dplars/TWI/LaTeX/template/bu/README

This is a template for the students from the FIIW, KU Leuven Technology campus De Nayer. Feel free to edit it to your needs.

The required files are: 
  parallel.sty
  fiiw_denayer_eng.sty
  cover_fiiw_denayer_eng.pdf
  back_fiiw_denayer_eng.pdf
  thesis.tex
The other files are examples.

Remarks can be sent to:
Jannes Verstichel <jannes.verstichel@cs.kuleuven.be>
