dplars/TWI/zim/Verslagen/Inloopperiode_verslag.txt

Content-Type: text/x-zim-wiki
Wiki-Format: zim 0.6
Creation-Date: 2020-11-20T12:22:35+01:00

====== Inloopperiode verslag ======
Created vrijdag 20 november 2020

Het ingediende inloopperiode verslag is [[~/Documents/Lars.nosync/Documents/School/1Ma ing/Masterproef/officiele documenten/Verslagen/Inloopperiode verslag/Definitief/InloopPeriodeVerslag_TWI.pdf|hier]] terug te vinden
