dplars/TWI/LaTeX/TussenTijdsVerslag/FromZim/Verslagen/Activiteiten_rapport/Done.tex

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

\usepackage{listings}

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

\title{Done}
\date{dinsdag 08 december 2020}
\author{}

\begin{document}

\maketitle

		\section{Done}

Created vrijdag 20 november 2020

\subsection{Wat is er reeds gedaan deze periode tot 10 November?}

\subsection{Week 05/10/2020 - 11/10/2020}

opstellen en indienen van het tussentijds verslag in de eerste helft van de week.

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

\subsection{Week 12/10/2020 - 18/10/2020}

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

\subsection{Week 19/10/2020 - 25/10/2020}

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

\subsection{Week 26/10/2020 - 1/11/2020}

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

\subsection{Week 02/11/2020 - 08/11/2020}

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

\subsection{Week 09/11/2020 - 15/11/2020}

\begin{enumerate}[1]
\item Oplossen van het \href{../../Code/Problems/arduino_loop_time.tex}{probleem van de trage communicatie} tussen de computer en arduino. 
	\begin{enumerate}[a]
	\item Dit lag aan een time delay die gezet was voor het inlezen van een nieuwe lijn van de seriele input. 
		\begin{enumerate}[1]
		\item door de tijd te verlagen van de delay was het probleem al grotendeels verholpen. (van 1 seconde naar 10 miliseconden)
		\item Door een nieuw line end karakter te kiezen was het probleem volledig weg. Dit stond op '$\backslash$0', wijzigen naar / was voldoende om het einde van de lijn aan te geven
		\end{enumerate}
	\end{enumerate}
\item Nieuwe foto's nemen met de aangepaste code. Te zien in second dataset
\item Een \href{../../Camera_setup/Tool_Holder/Wheel_Holder/Second_Wheel_Holder.tex}{nieuw rad} ontwerpen dat toelaat om de plaatjes makkelijker te monteren en demonteren door clips te gebruiken waardoor de plaatjes niet met hun snijkant moeten glijden over plastiek. Dit zorgt er ook voor dat de clips makkelijk kunnen aangepast worden om met toekomstige veranderingen mee te kunnen.
	\begin{enumerate}[a]
	\item Het 3D model van de plaatjes online gevonden waardoor de juiste afmetingen bekend waren.
	\item Het 3D model printen zorgde er voor dat de afmetingen van de modellen niet werden gerespecteerd. Hierdoor pasten de eerste tests niet. Door Steeds 0.4 mm extra te rekenen voor elke maat paste het wel. 
	\item De clips werden geprint met een langere midelste pin om deze makkelijk van het rad te kunnen verwijderen. 
	\end{enumerate}
\item Bijwonen van de presentaties van twee studenten die in januari hun masterproef zullen indienen om een beeld te krijgen van hoe de presentaties in elkaar zitten.
\item Alle bestanden die tot hiertoe gemaakt zijn reorganiseren en opslaan in GITHUB.
	\begin{enumerate}[a]
	\item werken met meerdere branches. 
	\item Master branch 
	\item develop branch
	\item feature/\textless{}featurename\textgreater{} branch
	\end{enumerate}
\item Belichten van de fotos verliep zeer goed, alleen was het zeer moeilijk om de camera te positioneren en scherp te stellen met de huidige standaard. Hiervoor werd gevraagd of nieuwe materialen konden besteld worden om deze standaard te vervangen.
\item Vraag om ander print materiaal te kunnen gebruiken voor de print van de clips. Nu werd witte PLA gebruikt wat nogal snel afbreekt, met PETG hopen we de problemen niet meer te hebben.
\item Aanmaken van een \href{../../Vision/Dataset/handmade_datasets/Second_handmade_dataset.tex}{nieuwe dataset} met de eerste batch van plaatjes gezien niet duidelijk was welke kant de a kant was en welke de b-kant.
	\begin{enumerate}[a]
	\item Dit werd gedaan met een simpele setup waarbij de camera op de bureau stond en handmatig werden van alle plaatjes foto's genomen en vergeleken met de gekregen foto's van Sirris.
	\item Blijkt dat de B kant de kant is met de streep
	\end{enumerate}
\end{enumerate}

\subsection{Week 16/11/2020 - 22/11/2020}

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

\subsection{Week 23/11/2020 - 29/11/2020}

Dinsdag 24/11/2020

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

Woensdag 25/11/2020

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

\subsection{Week 30/11/2020 - 06/12/2020}

Maandag, dinsdag

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

Woensdag

Overige clips en rad geprint en plaatjes op de raden gestoken. 

Een deel gedocumenteerd over de aangelegde datasets:

\begin{itemize}
\item \href{../../Vision/Dataset/automated_datasets/1_check_camera_position/1_camera_position_side.tex}{Vision:Dataset:automated datasets:1 check camera position:1 camera position side} aangevuld
\item \href{../../Vision/Dataset/automated_datasets/1_check_camera_position/2_camera_position_top.tex}{Vision:Dataset:automated datasets:1 check camera position:2 camera position top} aangevuld
\item \href{../../Vision/Dataset.tex}{Vision:Dataset} aangevuld
\end{itemize}

Afwerken van de setup door toevoeging van nieuwe staander voor motor

aanmaken van een nieuwe dataset genaamd spaghetti met vier foto's per plaatje

foto's van spaghetti door algoritme laten gaan en sweep laten uitvoeren. Eerste resultaten zien er zeer slecht uit. Slechtere accuracy dan bij de vorige dataset die met de hand was gemaakt. (\href{../../Vision/Dataset/handmade_datasets/Second_handmade_dataset.tex}{second handmade dataset)}

Wel meer data om te testen en valideren. Test resultaten zien er wel beter uit.

wandb proberen instellen om te runnen vanaf mijn eigen computer tot hiertoe zonder succes

Vrijdag

Documenteren van de verschillende tests die uitgevoerd werden op de verkregen datasets.

zie:

\begin{itemize}
\item \href{../../Vision/GoogleColab/Test_Camera_Setup/All_Networks/All_Networks_1.tex}{All networks 1}
\item \href{../../Vision/GoogleColab/Test_Camera_Setup/All_Networks/All_Networks_2.tex}{All networks 2}
\item \href{../../Vision/GoogleColab/Test_Camera_Setup/All_Networks/All_Networks_4_Spaghetti.tex}{All networks 4 Spaghetti}
\item \href{../../Vision/GoogleColab/Test_Camera_Setup/All_Networks/All_networks_4_spaghetti_first_5_batches.tex}{All networks 4 Spaghetti first 5 batches}
\end{itemize}

Aanmaken pagina met foto's van \href{../../Camera_setup/Tool_Holder/Wheel_Holder/Second_Wheel_Holder.tex}{nieuw rad v2}

Datasets documenteren:

\href{../../Vision/Dataset/automated_datasets/2_created_datasets/2_Spaghetti_dataset.tex}{Spaghetti dataset}

\end{document}
