dplars/TWI/LaTeX/TussenTijdsVerslag/FromZim/Vision/Dataset/camera_position.tex

\documentclass{scrartcl}
\usepackage[mathletters]{ucs}
\usepackage[utf8x]{inputenc}
\usepackage{amssymb}
\usepackage{amsmath}
\usepackage[usenames]{color}
\usepackage{hyperref}
\usepackage{wasysym}
\usepackage{graphicx}
\usepackage[normalem]{ulem}
\usepackage{enumerate}

\usepackage{listings}

\lstset{ %
basicstyle=\footnotesize,       % the size of the fonts that are used for the code
showspaces=false,               % show spaces adding particular underscores
showstringspaces=false,         % underline spaces within strings
showtabs=false,                 % show tabs within strings adding particular underscores
frame=single,                   % adds a frame around the code
tabsize=2,                      % sets default tabsize to 2 spaces
breaklines=true,                % sets automatic line breaking
breakatwhitespace=false,        % sets if automatic breaks should only happen at whitespace
}

\title{camera position}
\date{dinsdag 08 december 2020}
\author{}

\begin{document}

\maketitle

		\section{camera position}

Created woensdag 11 november 2020

1st test was with a camera position more to the side of the cutting plates. This resulted in a bad reflection angle since the light came from the wrong side. Documentation of this set is in \href{./automated_datasets/1_check_camera_position/1_camera_position_side.tex}{automated datasets:1 check camera position:1 camera position side} 

\end{document}
