dplars/TWI/LaTeX/TussenTijdsVerslag/FromZim/Vision/Dataset/handmade_datasets/second_initial_dataset.tex

\documentclass{scrartcl}
\usepackage[mathletters]{ucs}
\usepackage[utf8x]{inputenc}
\usepackage{amssymb}
\usepackage{amsmath}
\usepackage[usenames]{color}
\usepackage{hyperref}
\usepackage{wasysym}
\usepackage{graphicx}
\usepackage[normalem]{ulem}
\usepackage{enumerate}

\usepackage{listings}

\lstset{ %
basicstyle=\footnotesize,       % the size of the fonts that are used for the code
showspaces=false,               % show spaces adding particular underscores
showstringspaces=false,         % underline spaces within strings
showtabs=false,                 % show tabs within strings adding particular underscores
frame=single,                   % adds a frame around the code
tabsize=2,                      % sets default tabsize to 2 spaces
breaklines=true,                % sets automatic line breaking
breakatwhitespace=false,        % sets if automatic breaks should only happen at whitespace
}

\title{second initial dataset}
\date{dinsdag 08 december 2020}
\author{}

\begin{document}

\maketitle

		\section{second initial dataset}

Created vrijdag 04 december 2020

With the second number of inserts (batch 11 to 19) another dataset was created for measurement.

Since the photo's where labeled with two inserts at a time; the images taken where not relevant for the data processing and were not saved

The distance for these inserts is measured between the line connecting the two highest points visible on the insert and the outer most point of the wear area.

\end{document}
