dplars/TWI/zim/Code/Arduino/Control_motor_leds.txt

Content-Type: text/x-zim-wiki
Wiki-Format: zim 0.6
Creation-Date: 2020-12-02T17:33:06+01:00

====== Control motor leds ======
Created woensdag 02 december 2020

current working file is control_motor_leds
