dplars/TWI/LaTeX/template/private_oudestijl/back_fiiw_bruges_eng.pdf

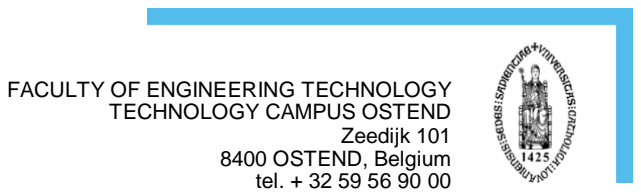
[picture p57: figure]
FACULTY OF ENGINEERING TECHNOLOGY TECHNOLOGY CAMPUS OSTEND Zeedijk 101 8400 OSTEND, Belgium

tel. + 32 59 56 90 00
fet.ostend@kuleuven.be
www.fet.kuleuven.be
