dplars/TWI/LaTeX/template/private_oudestijl/back_fiiw_denayer_eng.pdf

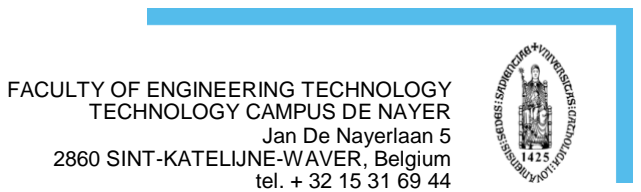
[picture p58: figure]
FACULTY OF ENGINEERING TECHNOLOGY TECHNOLOGY CAMPUS DE NAYER Jan De Nayerlaan 5 2860 SINT-KATELIJNE-WAVER, Belgium

tel. + 32 15 31 69 44
fet.denayer@kuleuven.be
www.fet.kuleuven.be
