dplars/TWI/LaTeX/template/private_oudestijl/back_fiiw_geel_eng.pdf

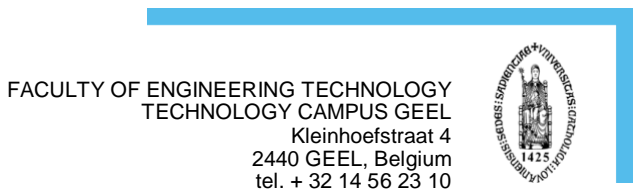
[picture p59: figure]
FACULTY OF ENGINEERING TECHNOLOGY TECHNOLOGY CAMPUS GEEL Kleinhoefstraat 4 2440 GEEL, Belgium

tel. + 32 14 56 23 10
fax + 32 14 58 48 59
fet.geel@kuleuven.be
www.fet.kuleuven.be
