dplars/TWI/LaTeX/template/bijlage1.tex

\chapter{Uitleg over de appendices}
Bijlagen worden bij voorkeur enkel elektronisch ter beschikking gesteld. Indien essentieel kunnen in overleg met de promotor bijlagen in de scriptie opgenomen worden of als apart boekdeel voorzien worden.

Er wordt wel steeds een lijst met vermelding van alle bijlagen opgenomen in de scriptie. Bijlagen worden genummerd het een drukletter A, B, C,...

Voorbeelden van bijlagen:\\
Bijlage A: \qquad	Detailtekeningen van de proefopstelling \\
Bijlage B: \qquad	Meetgegevens (op USB)
\\
