dplars/TWI/LaTeX/template/samenvatting.tex

De (korte) samenvatting, toegankelijk voor een breed publiek, wordt in het Nederlands geschreven en bevat {\bf maximum 3500 tekens}. Deze samenvatting moet ook verplicht opgeladen worden in KU Loket.
