dplars/TWI/LaTeX/template/voorwoord.tex

Het voorwoord vul je persoonlijk in met een appreciatie of dankbetuiging aan de mensen die je hebben bijgestaan tijdens het verwezenlijken van je masterproef en je hebben gesteund tijdens je studie.
