dplars/TWI/LaTeX/template/bu/samenvatting.tex

De (korte) samenvatting, toegankelijk voor een breed publiek, wordt in het Nederlands geschreven en bevat maximum 3500 tekens. Deze samenvatting moet ook verplicht opgeladen worden in KU Loket.
