dplars/TWI/LaTeX/template/private_oudestijl/back_fiiw_brugge.pdf

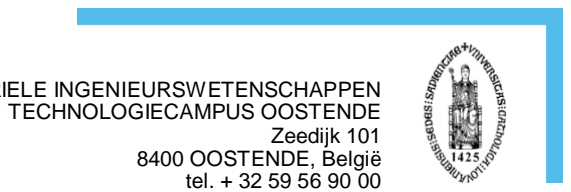
[picture p61: figure]
TECHNOLOGIECAMPUS OOSTENDE Zeedijk 101 8400 OOSTENDE, België

FACULTEIT INDUSTRIELE INGENIEURSWETENSCHAPPEN

tel. + 32 59 56 90 00
iiw.oostende@kuleuven.be
www.iiw.kuleuven.be
