dplars/TWI/LaTeX/template/private_oudestijl/back_fiiw_denayer.pdf

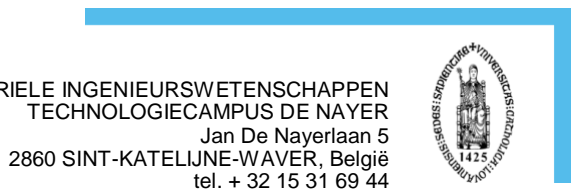
[picture p62: figure]
TECHNOLOGIECAMPUS DE NAYER Jan De Nayerlaan 5 2860 SINT-KATELIJNE-WAVER, België

FACULTEIT INDUSTRIELE INGENIEURSWETENSCHAPPEN

tel. + 32 15 31 69 44
iiw.denayer@kuleuven.be
www.iiw.kuleuven.be
