dplars/TWI/LaTeX/template/private_oudestijl/back_fiiw_geel.pdf

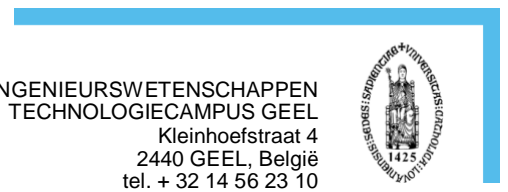
[picture p63: figure]
TECHNOLOGIECAMPUS GEEL Kleinhoefstraat 4 2440 GEEL, België

FACULTEIT INDUSTRIELE INGENIEURSWETENSCHAPPEN

tel. + 32 14 56 23 10
fax + 32 14 58 48 59
iiw.geel@kuleuven.be
www.iiw.kuleuven.be
