dplars/TWI/LaTeX/template/private_oudestijl/back_fiiw_groepT.pdf

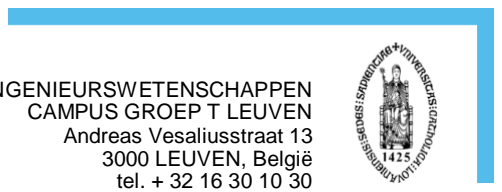
[picture p64: figure]
CAMPUS GROEP T LEUVEN Andreas Vesaliusstraat 13 3000 LEUVEN, België

FACULTEIT INDUSTRIELE INGENIEURSWETENSCHAPPEN

tel. + 32 16 30 10 30
fax + 32 16 30 10 40
iiw.groept @kuleuven.be
www.iiw.kuleuven.be
