dplars/TWI/LaTeX/TussenTijdsVerslag/TexMaker/fig/Verslagen/Activiteiten_rapport/Activities/Masterproef_Tool_Wear_Inspection_-_Update_2_DH/20201021_1725_004_0.000.jpg

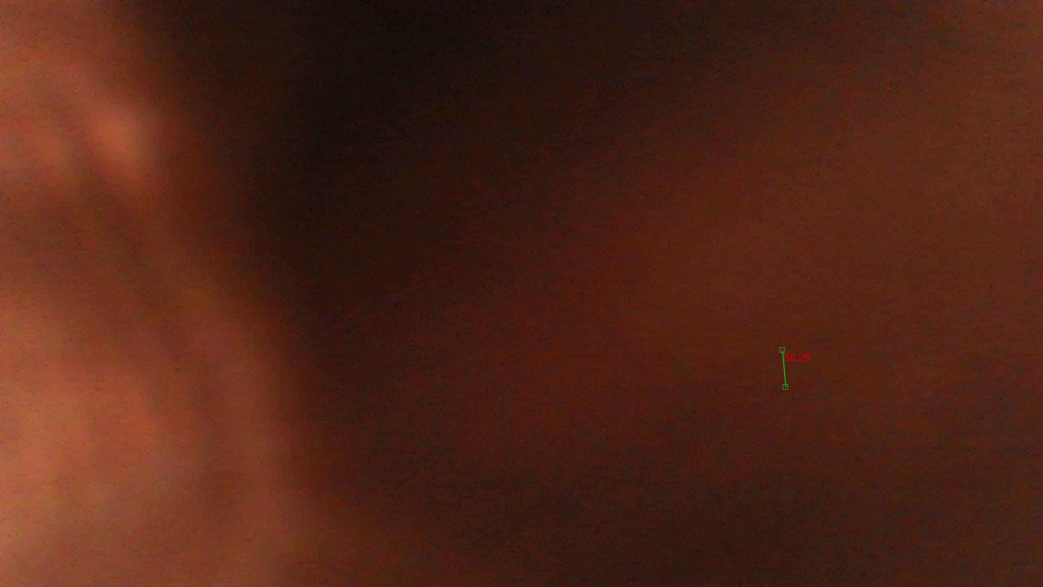
LaTeX/TussenTijdsVerslag/TexMaker/fig/Verslagen/Activiteiten_rapport/Activities/Masterproef_Tool_Wear_Inspection_-_Update_2_DH/20201021_1725_004_0.000.jpg
