dplars/TWI/LaTeX/TussenTijdsVerslag/TexMaker/fig/Verslagen/Activiteiten_rapport/Activities/Masterproef_Tool_Wear_Inspection_-_Update_2_DH/pasted_image.tiff

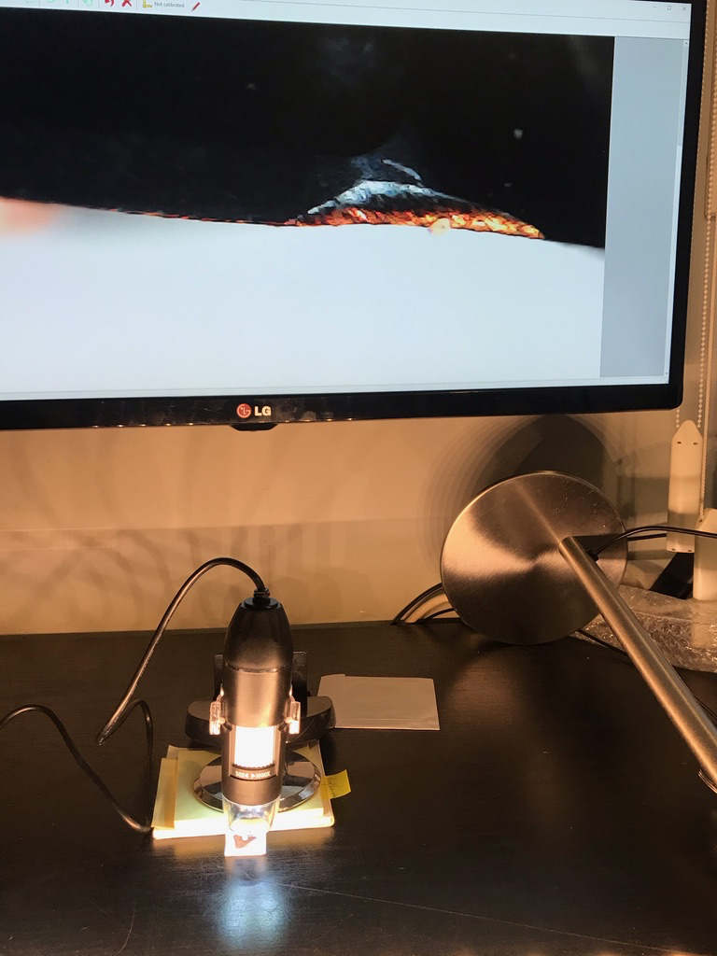
LaTeX/TussenTijdsVerslag/TexMaker/fig/Verslagen/Activiteiten_rapport/Activities/Masterproef_Tool_Wear_Inspection_-_Update_2_DH/pasted_image.tiff
