dplars/TWI/3Dprint/2020_profile/2020-aluminum-profile-1.snapshot.2/PROFILE_20х20.STEP

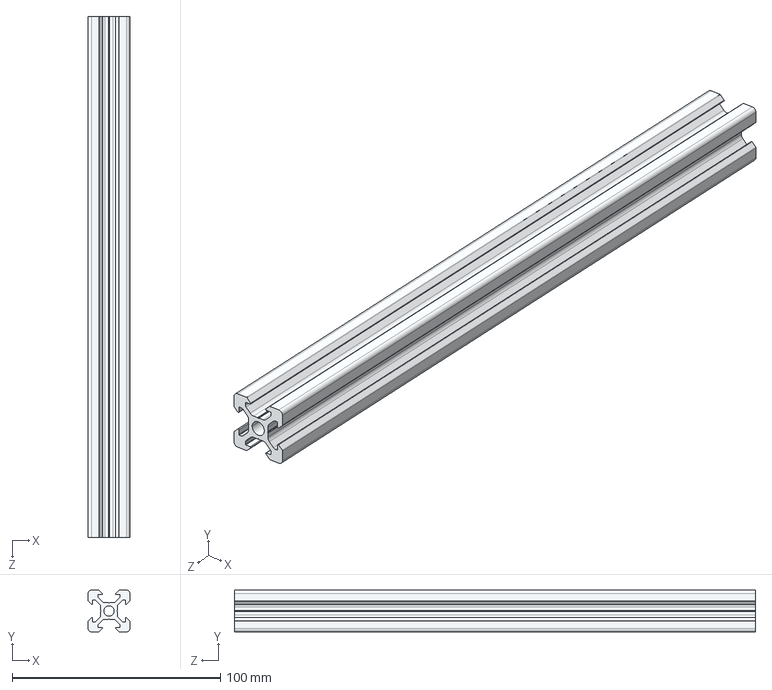
[picture p67: CAD file, 2020-12-16]
3Dprint/2020_profile/2020-aluminum-profile-1.snapshot.2/PROFILE_20х20.STEP
20.0 x 20.0 x 250.0 mm
