dplars/TWI/3Dprint/camera/USB Microscope_Generic/USB_Microscope_R0.SLDPRT

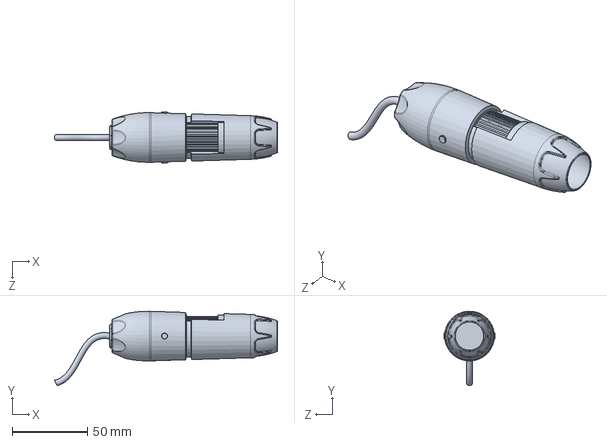
[picture p68: CAD file, 2020-12-12]
3Dprint/camera/USB Microscope_Generic/USB_Microscope_R0.SLDPRT
148.1 x 49.5 x 34.0 mm
