dplars/TWI/3Dprint/microscoophouder/20x20-shaped-aluminum-coupling-1.snapshot.1/20x20(tri2).stp

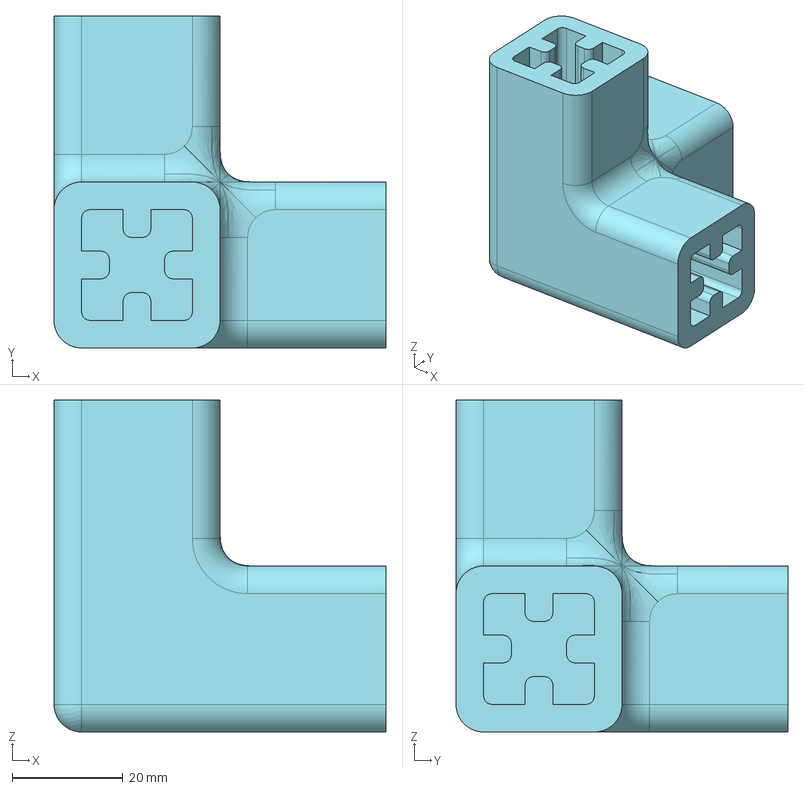
[picture p69: CAD file, 2020-12-02]
3Dprint/microscoophouder/20x20-shaped-aluminum-coupling-1.snapshot.1/20x20(tri2).stp
60.0 x 60.0 x 60.0 mm
