dplars/TWI/3Dprint/microscoophouder/camera_klem_1.stl

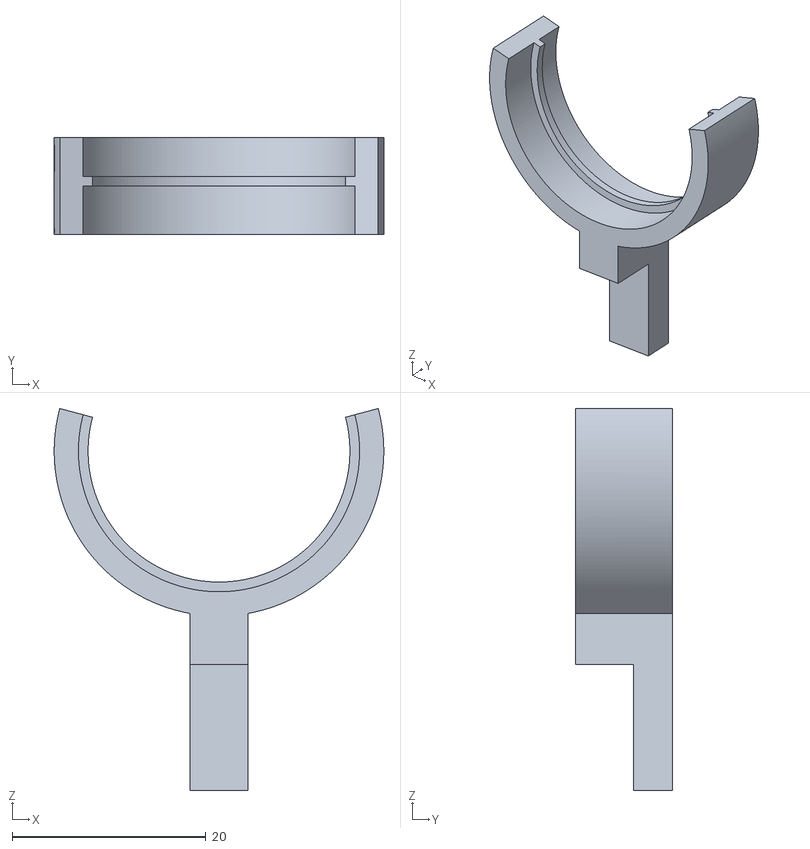
[picture p70: CAD file, 2020-12-02]
3Dprint/microscoophouder/camera_klem_1.stl
34.0 x 10.00 x 39.4
