dplars/TWI/3Dprint/radhouder_v2/clip_9.stl

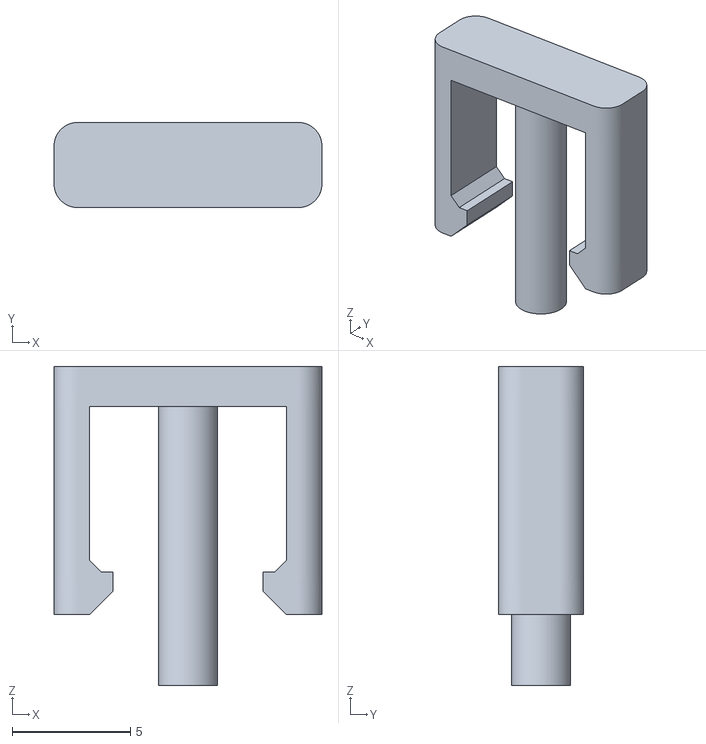
[picture p71: CAD file, 2020-12-04]
3Dprint/radhouder_v2/clip_9.stl
11.3 x 3.60 x 13.5
