dplars/TWI/3Dprint/setup/nema-17-22.snapshot.3/Holder nema17.SLDPRT

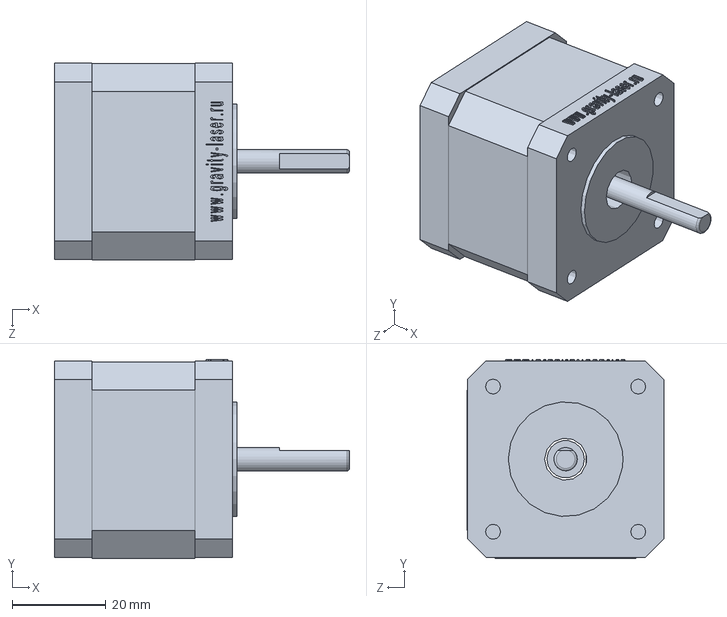
[picture p72: CAD file, 2020-12-16]
3Dprint/setup/nema-17-22.snapshot.3/Holder nema17.SLDPRT
63.0 x 42.5 x 42.1 mm
