dplars/TWI/3Dprint/Simpelehouder/klikhouder.stl

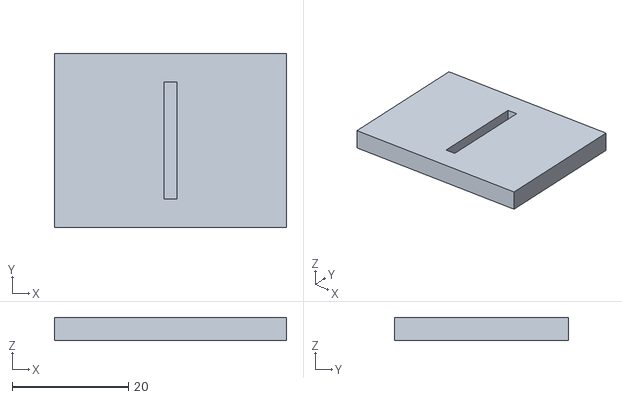
[picture p73: CAD file, 2020-11-13]
3Dprint/Simpelehouder/klikhouder.stl
40.0 x 30.0 x 4.00
