dplars/TWI/LaTeX/TussenTijdsVerslag/FromZim/Camera_setup/Tool_Holder/Wheel_Holder/radhouder.stl

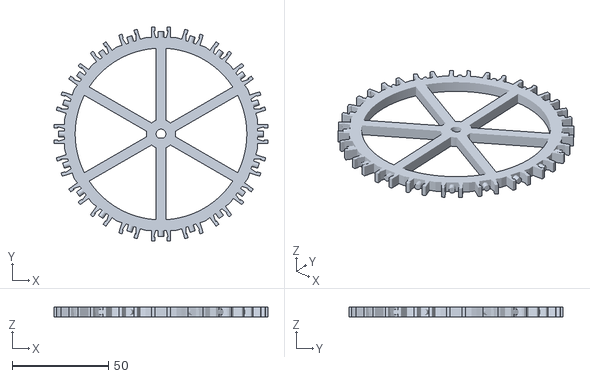
[picture p74: CAD file, 2020-11-13]
LaTeX/TussenTijdsVerslag/FromZim/Camera_setup/Tool_Holder/Wheel_Holder/radhouder.stl
111.0 x 111.0 x 5.00
