dplars/TWI/3Dprint/camera/USB Microscope_Generic/USB Microscope_Generic.STEP

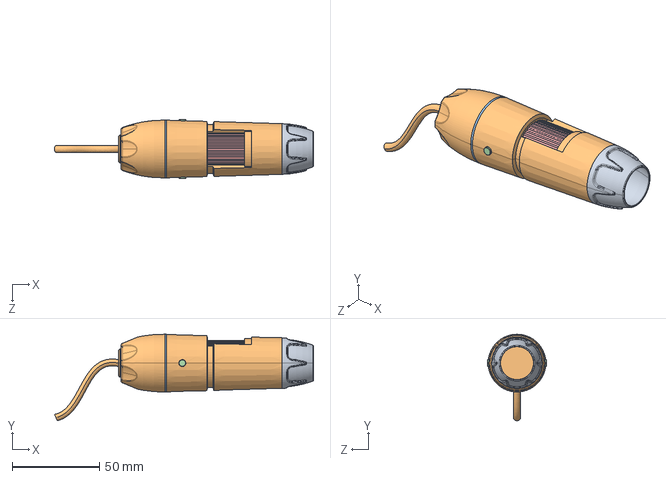
[picture p75: CAD file, 2020-12-12]
3Dprint/camera/USB Microscope_Generic/USB Microscope_Generic.STEP
148.1 x 49.5 x 34.0 mm
