dplars/TWI/3Dprint/microscoophouder/20x20-shaped-aluminum-coupling-1.snapshot.1/20x20(tri1).stp

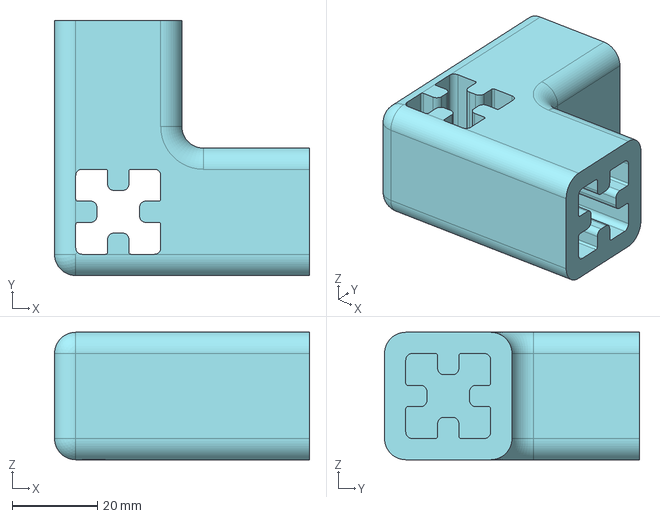
[picture p76: CAD file, 2020-12-02]
3Dprint/microscoophouder/20x20-shaped-aluminum-coupling-1.snapshot.1/20x20(tri1).stp
60.0 x 60.0 x 30.0 mm
