dplars/TWI/3Dprint/microscoophouder/Fuehrung_2020.stl

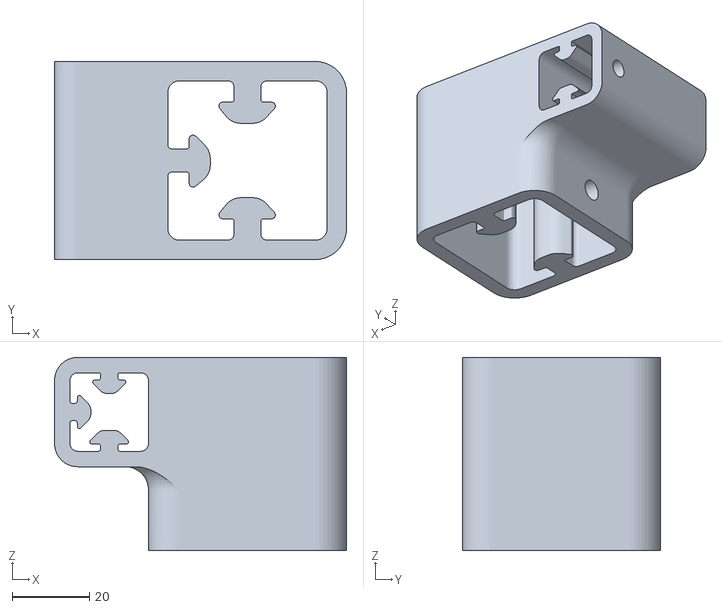
[picture p77: CAD file, 2020-12-02]
3Dprint/microscoophouder/Fuehrung_2020.stl
75.5 x 51.2 x 50.0
