dplars/TWI/3Dprint/radhouder_v2/clip_8.stl

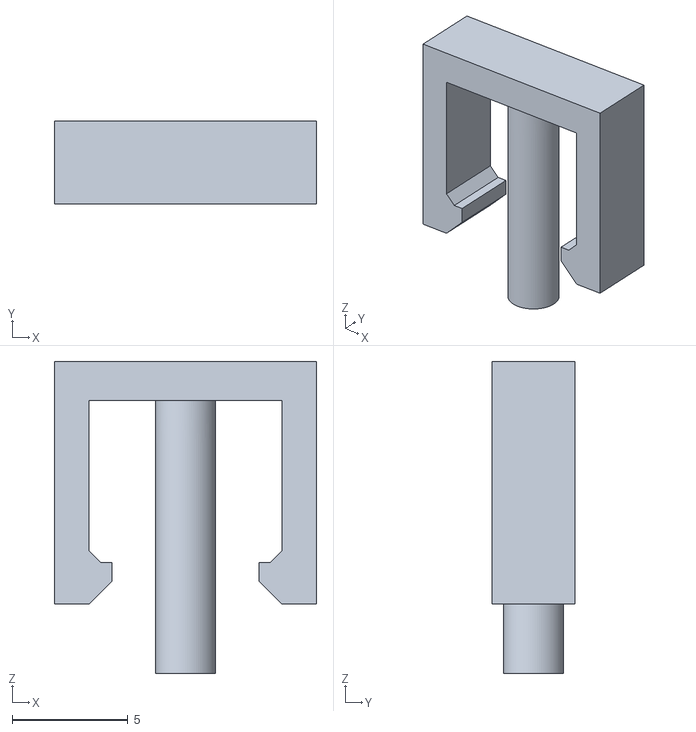
[picture p78: CAD file, 2020-12-02]
3Dprint/radhouder_v2/clip_8.stl
11.3 x 3.60 x 13.5
