dplars/TWI/3Dprint/Simpelehouder/simpeleHouderVertikaal.stl

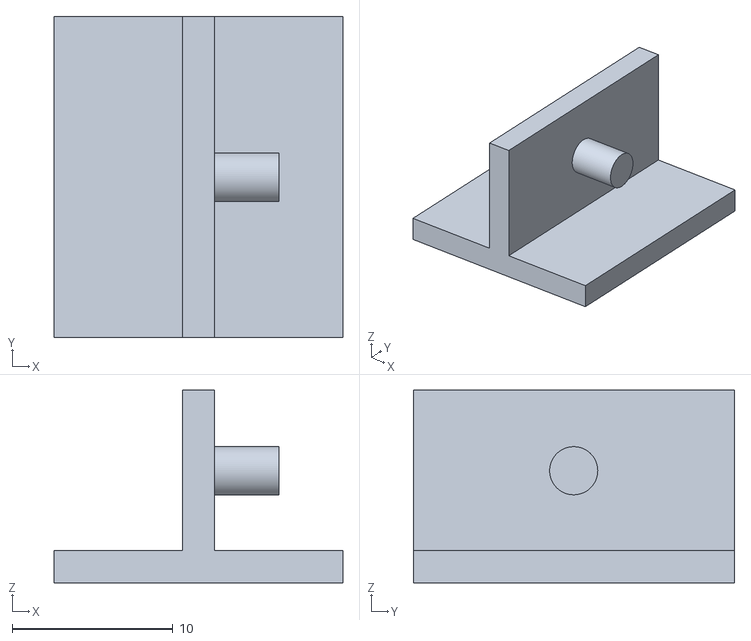
[picture p79: CAD file, 2020-11-13]
3Dprint/Simpelehouder/simpeleHouderVertikaal.stl
18.0 x 20.0 x 12.0
