dplars/TWI/3Dprint/microscoophouder/20x20-shaped-aluminum-coupling-1.snapshot.1/20x20(but).stp

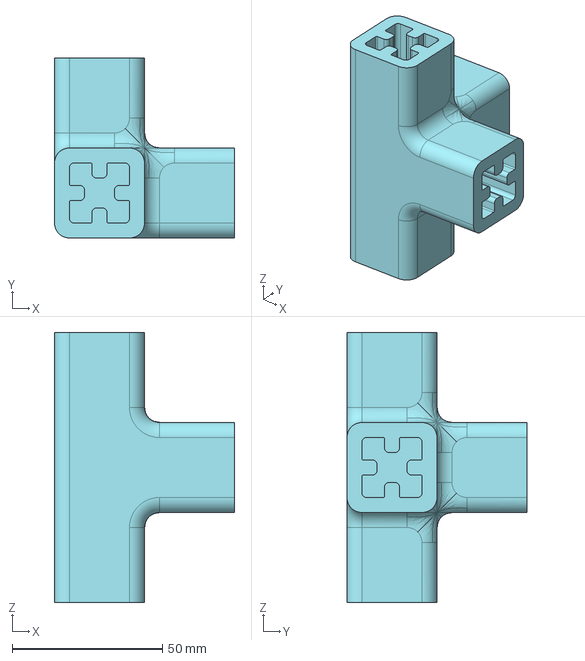
[picture p80: CAD file, 2020-12-02]
3Dprint/microscoophouder/20x20-shaped-aluminum-coupling-1.snapshot.1/20x20(but).stp
60.0 x 60.0 x 90.0 mm
