dplars/TWI/3Dprint/microscoophouder/mount.stl

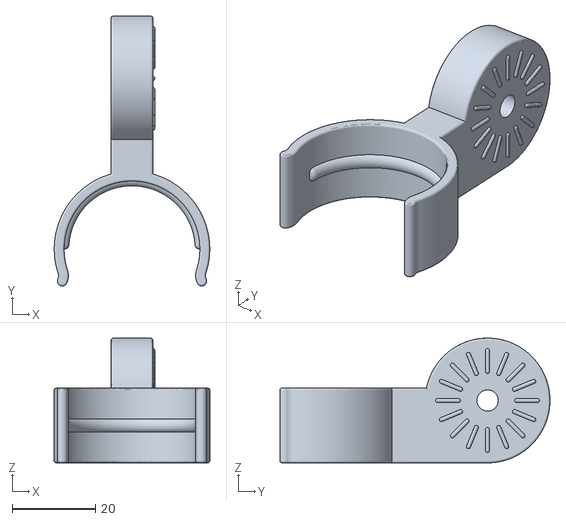
[picture p81: CAD file, 2020-12-02]
3Dprint/microscoophouder/mount.stl
37.4 x 64.9 x 30.0
