dplars/TWI/3Dprint/radhouder_v2/clip_p_5.stl

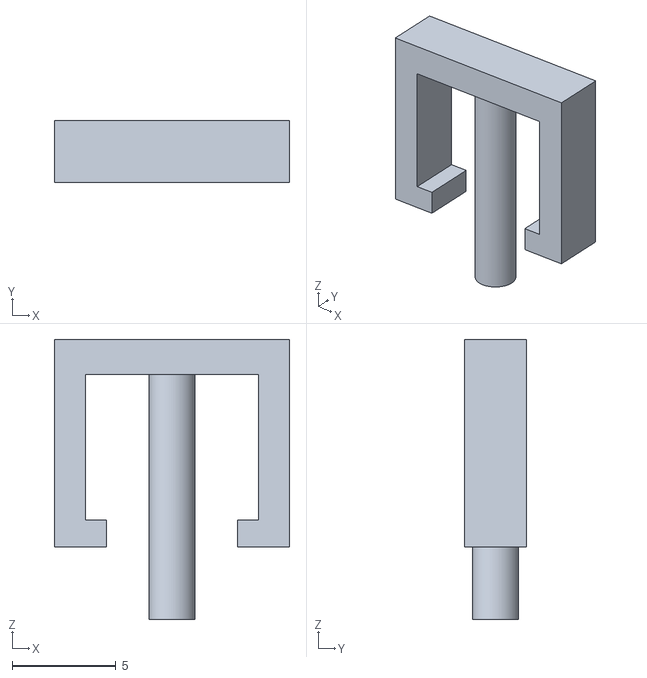
[picture p82: CAD file, 2020-12-02]
3Dprint/radhouder_v2/clip_p_5.stl
11.3 x 3.00 x 13.5
