dplars/TWI/3Dprint/Simpelehouder/simpeleHouder2.stl

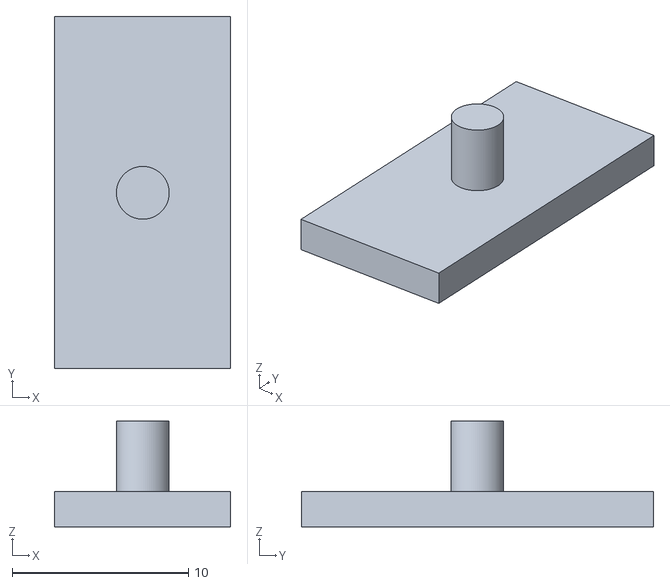
[picture p83: CAD file, 2020-11-13]
3Dprint/Simpelehouder/simpeleHouder2.stl
10.0 x 20.0 x 6.00
