dplars/TWI/3Dprint/microscoophouder/20x20-shaped-aluminum-coupling-1.snapshot.1/20x20(Double).stp

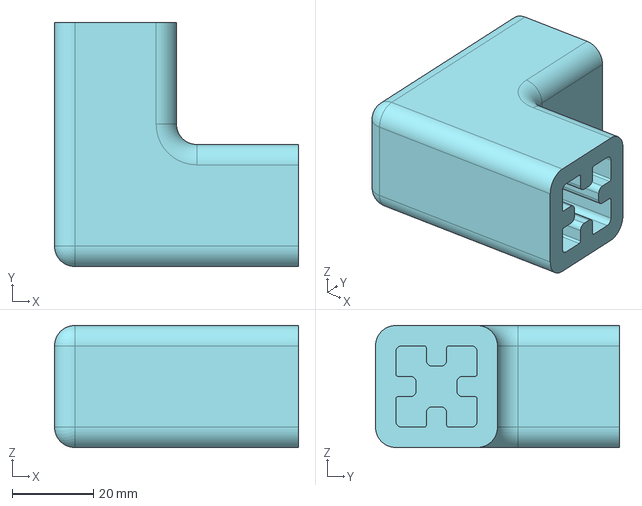
[picture p84: CAD file, 2020-12-02]
3Dprint/microscoophouder/20x20-shaped-aluminum-coupling-1.snapshot.1/20x20(Double).stp
60.0 x 60.0 x 30.0 mm
