dplars/TWI/3Dprint/microscoophouder/camera_houder_draai_houder_3.stl

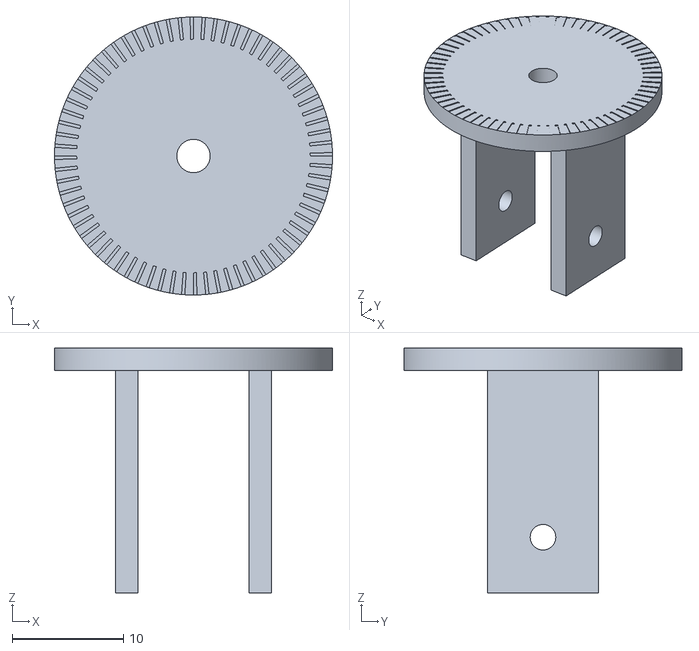
[picture p85: CAD file, 2020-12-02]
3Dprint/microscoophouder/camera_houder_draai_houder_3.stl
25.0 x 25.0 x 22.0
