dplars/TWI/3Dprint/radhouder_v2/clip_7.stl

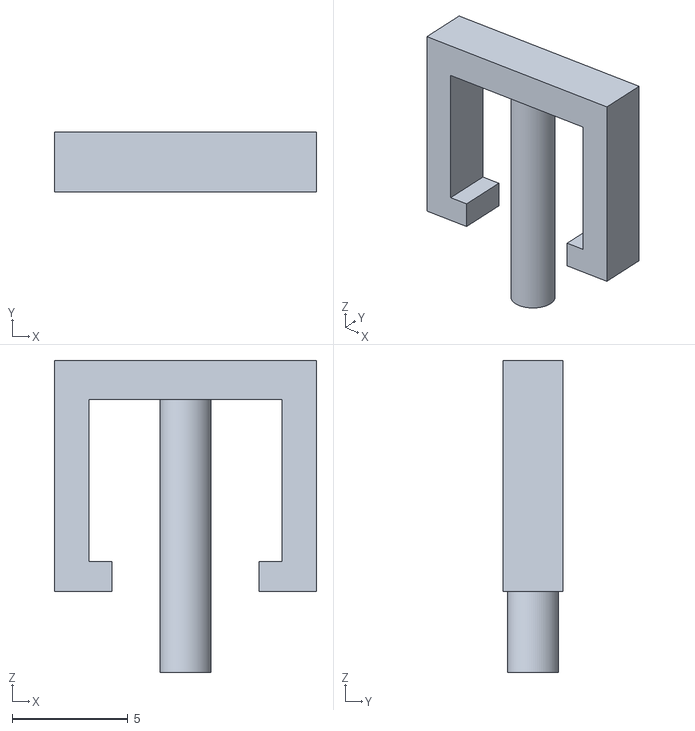
[picture p86: CAD file, 2020-12-02]
3Dprint/radhouder_v2/clip_7.stl
11.3 x 2.60 x 13.5
