dplars/TWI/3Dprint/Simpelehouder/simpelehouder_30grad.stl

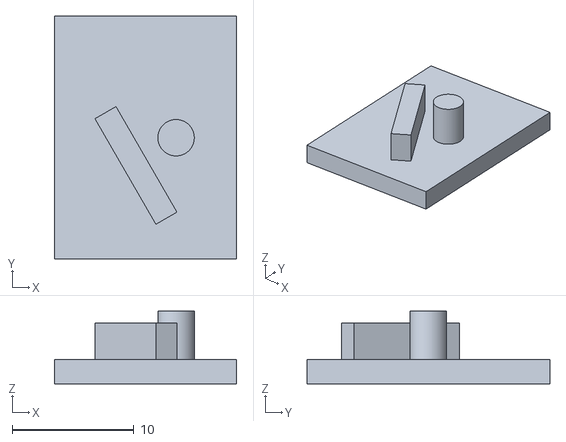
[picture p87: CAD file, 2020-11-13]
3Dprint/Simpelehouder/simpelehouder_30grad.stl
15.0 x 20.0 x 6.00
