dplars/TWI/3Dprint/microscoophouder/camera_houder_klem_3.stl

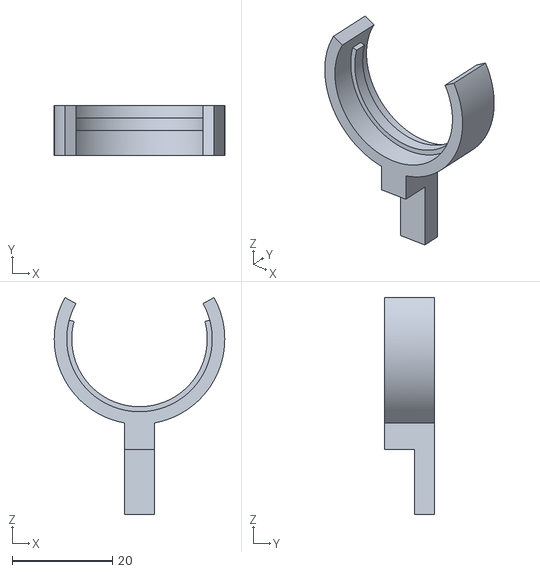
[picture p88: CAD file, 2020-12-02]
3Dprint/microscoophouder/camera_houder_klem_3.stl
34.0 x 10.00 x 43.3
