dplars/TWI/3Dprint/Simpelehouder/simpeleHouder_bredevoet.stl

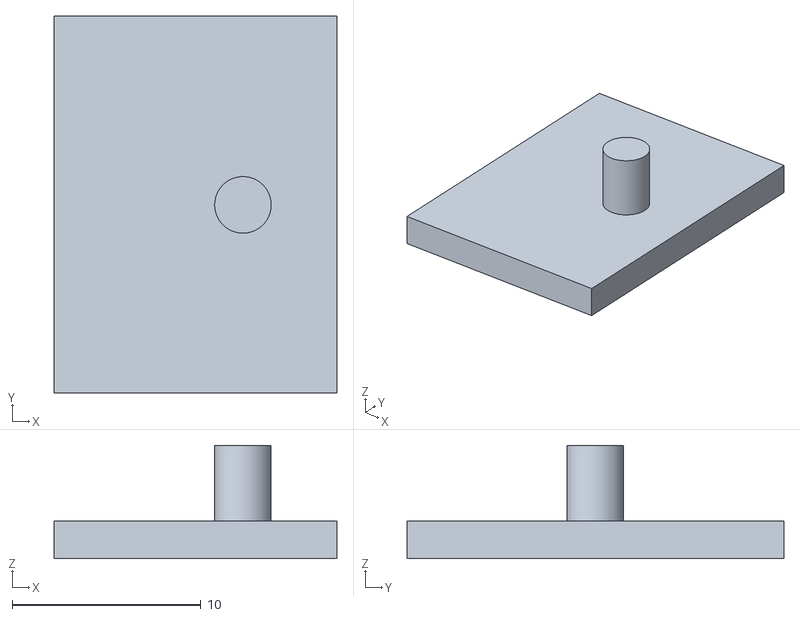
[picture p89: CAD file, 2020-11-13]
3Dprint/Simpelehouder/simpeleHouder_bredevoet.stl
15.0 x 20.0 x 6.00
