dplars/TWI/3Dprint/microscoophouder/2020_camera houder v1.stl

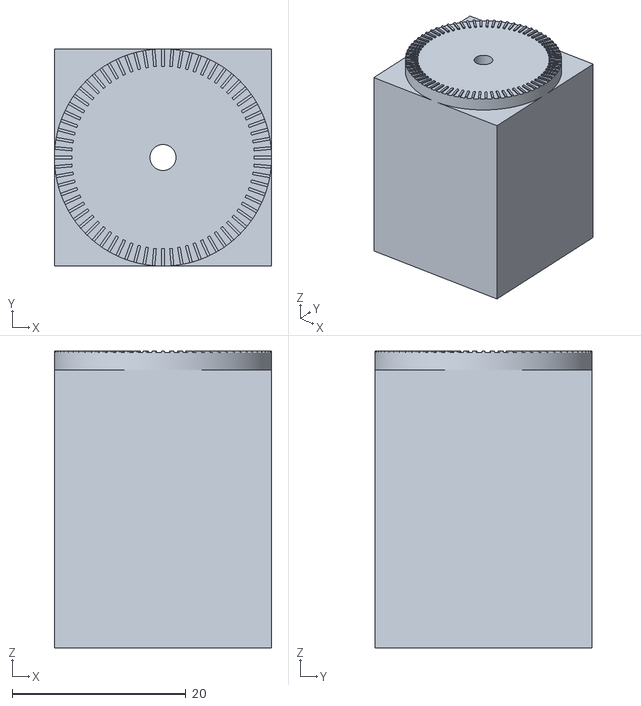
[picture p90: CAD file, 2020-12-02]
3Dprint/microscoophouder/2020_camera houder v1.stl
25.0 x 25.0 x 34.2
