dplars/TWI/3Dprint/radhouder_v2/radhouder_v2_num_V2.stl

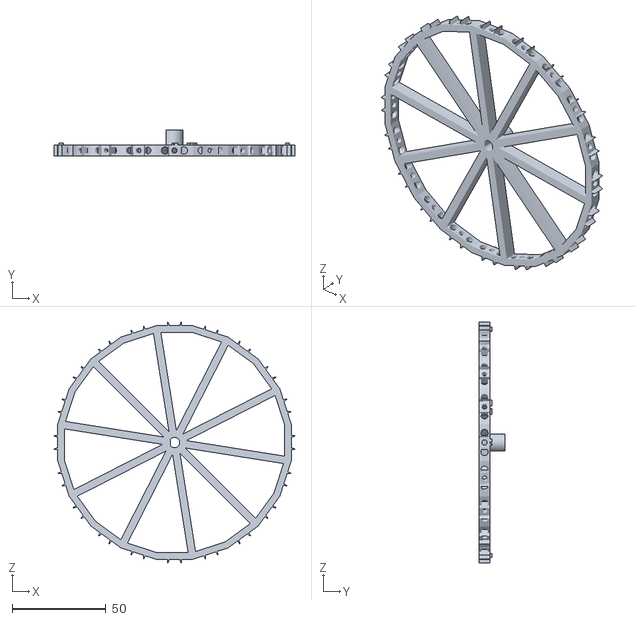
[picture p91: CAD file, 2020-11-24]
3Dprint/radhouder_v2/radhouder_v2_num_V2.stl
128.8 x 14.0 x 128.8
