dplars/TWI/3Dprint/Simpelehouder/houder_afgeschuind_30grad.stl

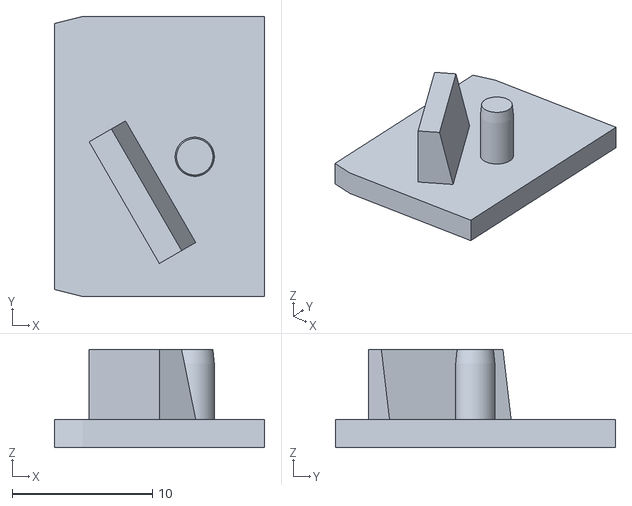
[picture p92: CAD file, 2020-11-13]
3Dprint/Simpelehouder/houder_afgeschuind_30grad.stl
15.0 x 20.0 x 7.00
