dplars/TWI/3Dprint/microscoophouder/camera_houder_klem_7.stl

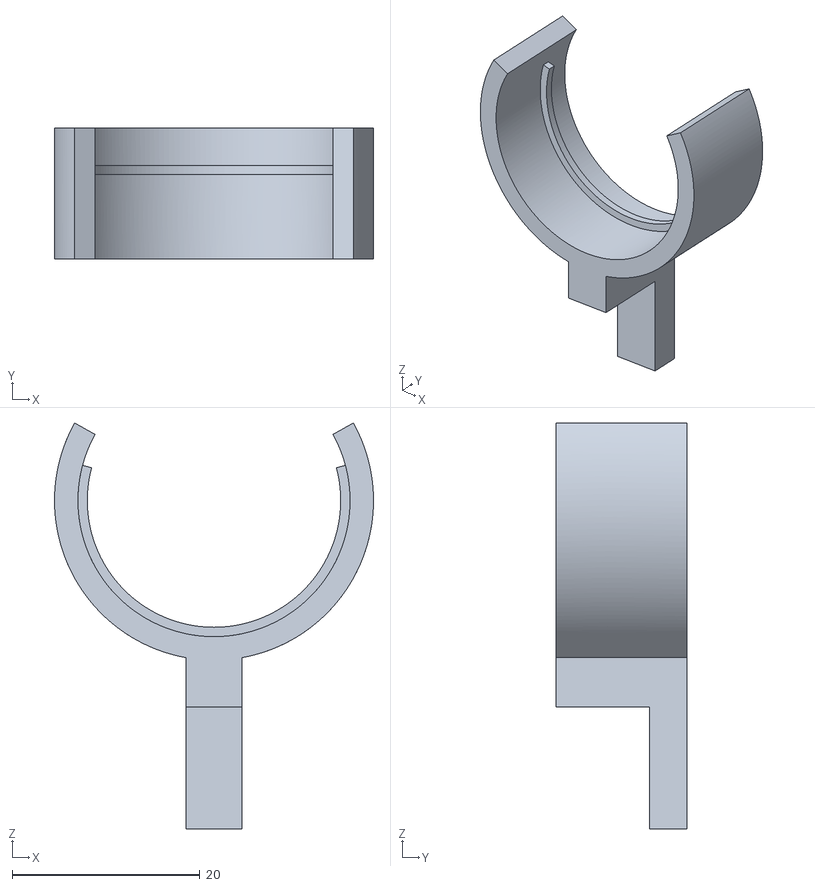
[picture p93: CAD file, 2020-12-02]
3Dprint/microscoophouder/camera_houder_klem_7.stl
34.0 x 14.0 x 43.3
