dplars/TWI/3Dprint/Simpelehouder/simpeleHouder.stl

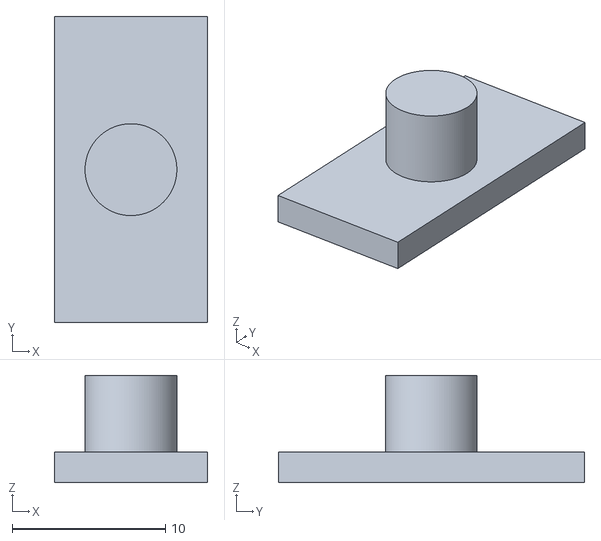
[picture p94: CAD file, 2020-11-13]
3Dprint/Simpelehouder/simpeleHouder.stl
10.0 x 20.0 x 7.00
