dplars/TWI/3Dprint/microscoophouder/2020_camerahouder.stl

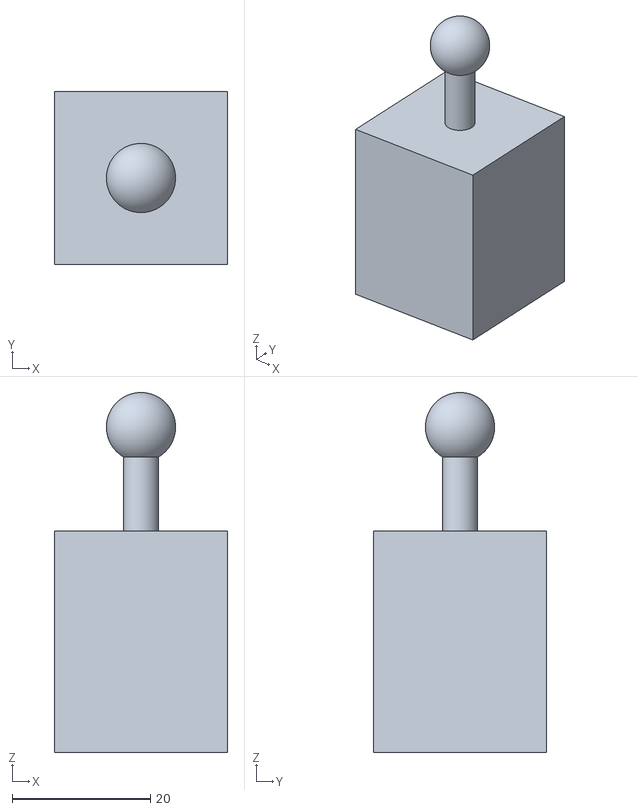
[picture p95: CAD file, 2020-12-02]
3Dprint/microscoophouder/2020_camerahouder.stl
25.0 x 25.0 x 52.0
