dplars/TWI/3Dprint/microscoophouder/2020_camera houder_draai_houder.stl

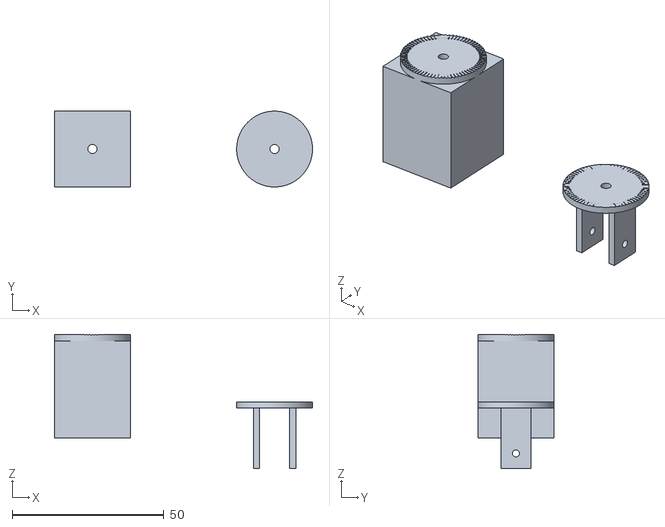
[picture p96: CAD file, 2020-12-02]
3Dprint/microscoophouder/2020_camera houder_draai_houder.stl
85.0 x 25.0 x 44.2
