dplars/TWI/3Dprint/radhouder_v2/clip_p_4.stl

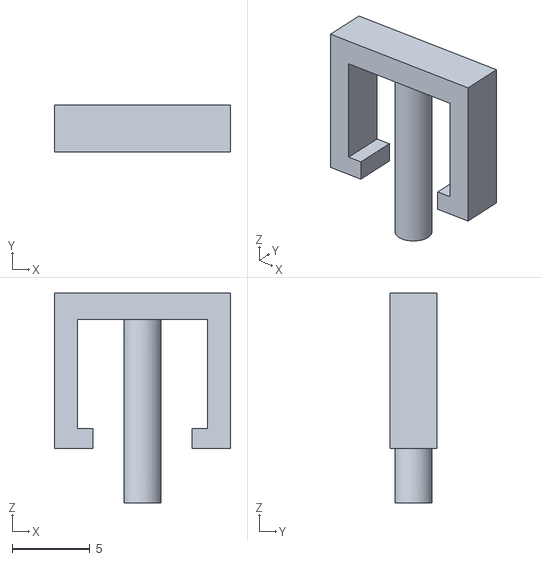
[picture p97: CAD file, 2020-11-13]
3Dprint/radhouder_v2/clip_p_4.stl
11.3 x 3.00 x 13.5
