dplars/TWI/3Dprint/microscoophouder/xy_joint.stl

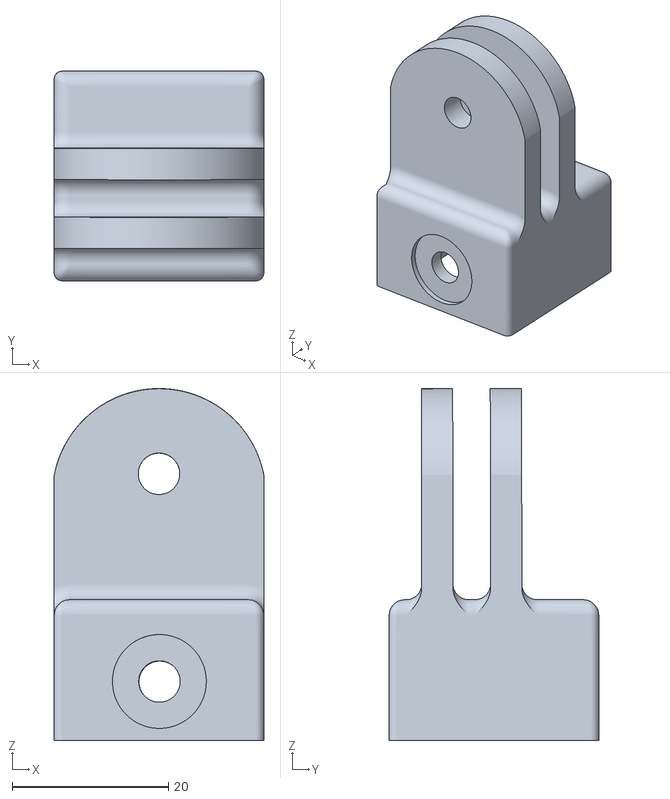
[picture p98: CAD file, 2020-12-02]
3Dprint/microscoophouder/xy_joint.stl
26.8 x 26.8 x 45.0
