dplars/TWI/3Dprint/radhouder_v2/rad2.stl

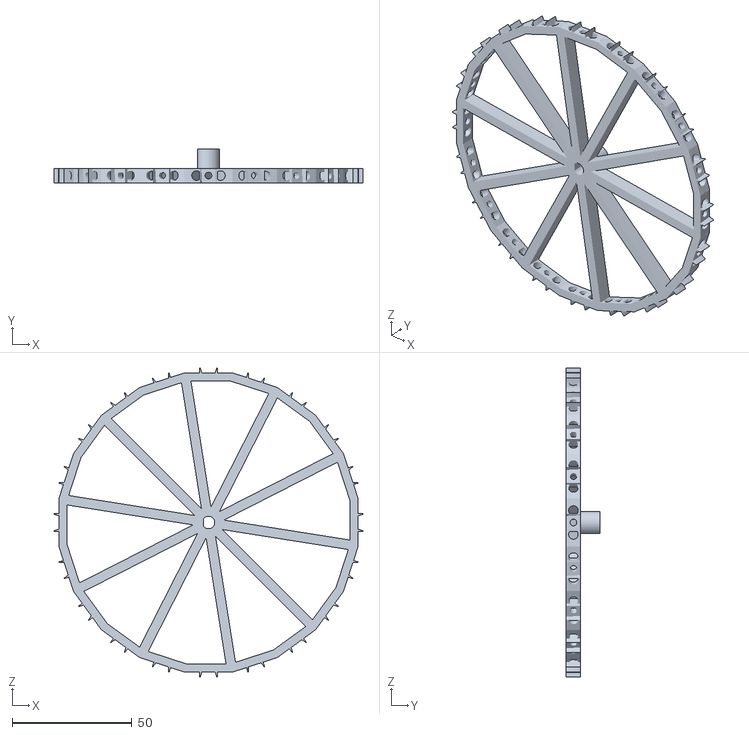
[picture p99: CAD file, 2020-11-13]
3Dprint/radhouder_v2/rad2.stl
128.8 x 14.0 x 128.8
