dplars/TWI/3Dprint/microscoophouder/camera_houder_klem_houder_5.stl

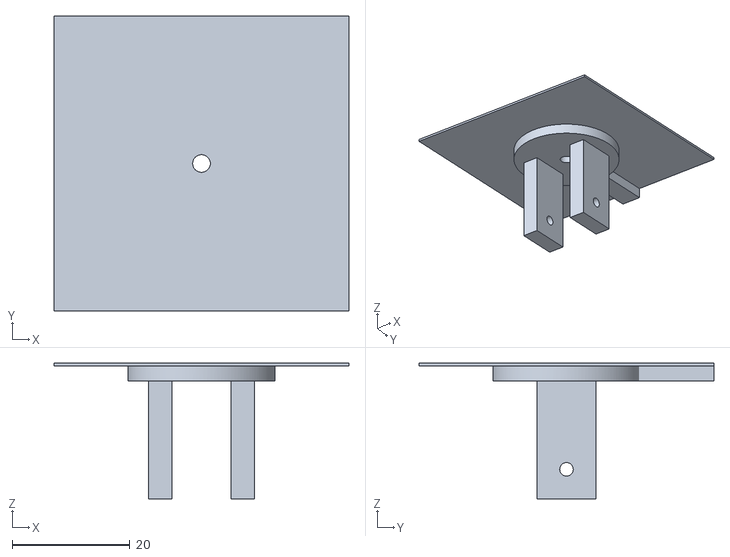
[picture p100: CAD file, 2020-12-02]
3Dprint/microscoophouder/camera_houder_klem_houder_5.stl
50.0 x 50.0 x 23.0
