dplars/TWI/3Dprint/radhouder_v2/clip_p_3.stl

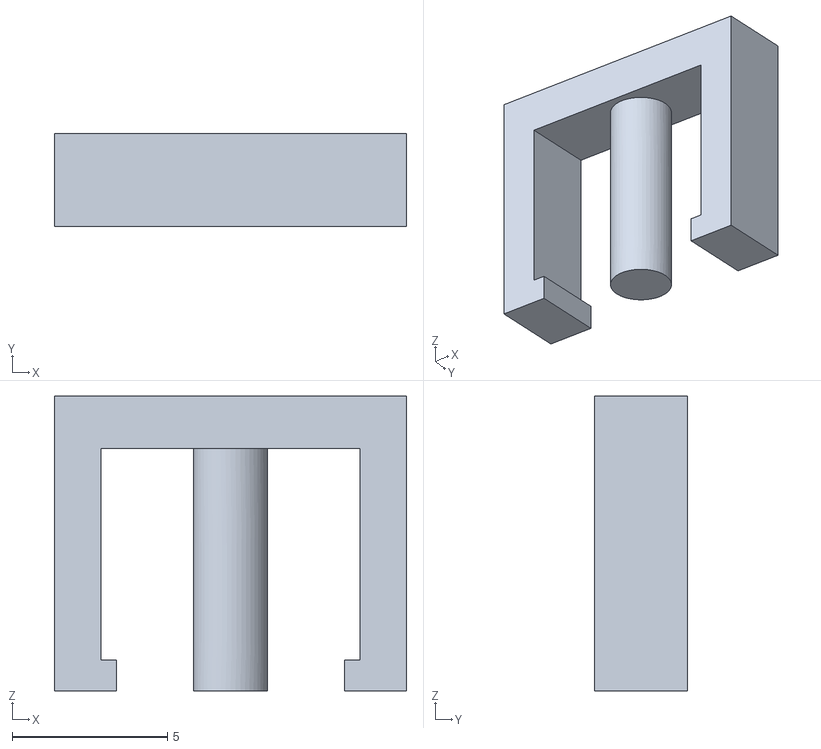
[picture p101: CAD file, 2020-11-13]
3Dprint/radhouder_v2/clip_p_3.stl
11.3 x 3.00 x 9.50
