dplars/TWI/3Dprint/microscoophouder/ch_square_pin.stl

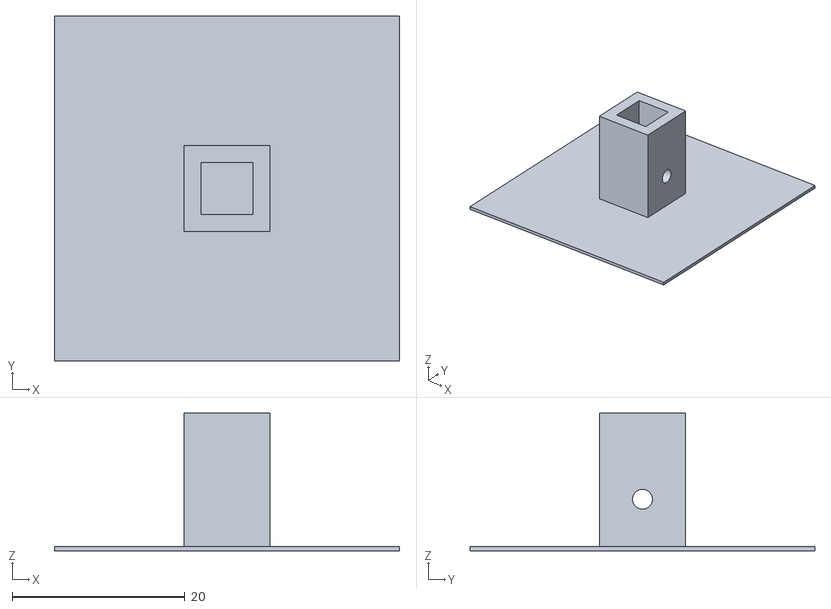
[picture p102: CAD file, 2020-12-02]
3Dprint/microscoophouder/ch_square_pin.stl
40.0 x 40.0 x 16.0
