dplars/TWI/3Dprint/radhouder_v2/radhouder_V2_1.stl

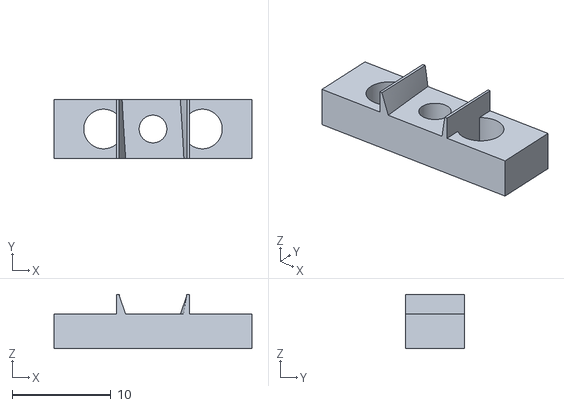
[picture p103: CAD file, 2020-11-13]
3Dprint/radhouder_v2/radhouder_V2_1.stl
20.0 x 6.00 x 5.50
