dplars/TWI/3Dprint/microscoophouder/2020_camera_houder_2.stl

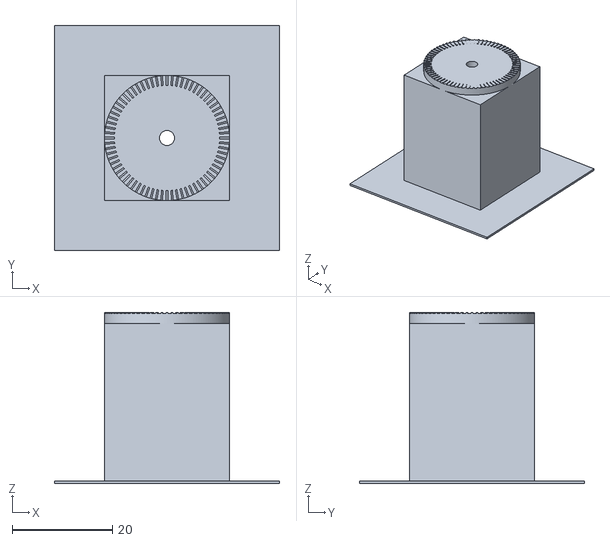
[picture p104: CAD file, 2020-12-02]
3Dprint/microscoophouder/2020_camera_houder_2.stl
45.0 x 45.0 x 34.2
