dplars/TWI/3Dprint/radhouder_v2/clip_p_2.stl

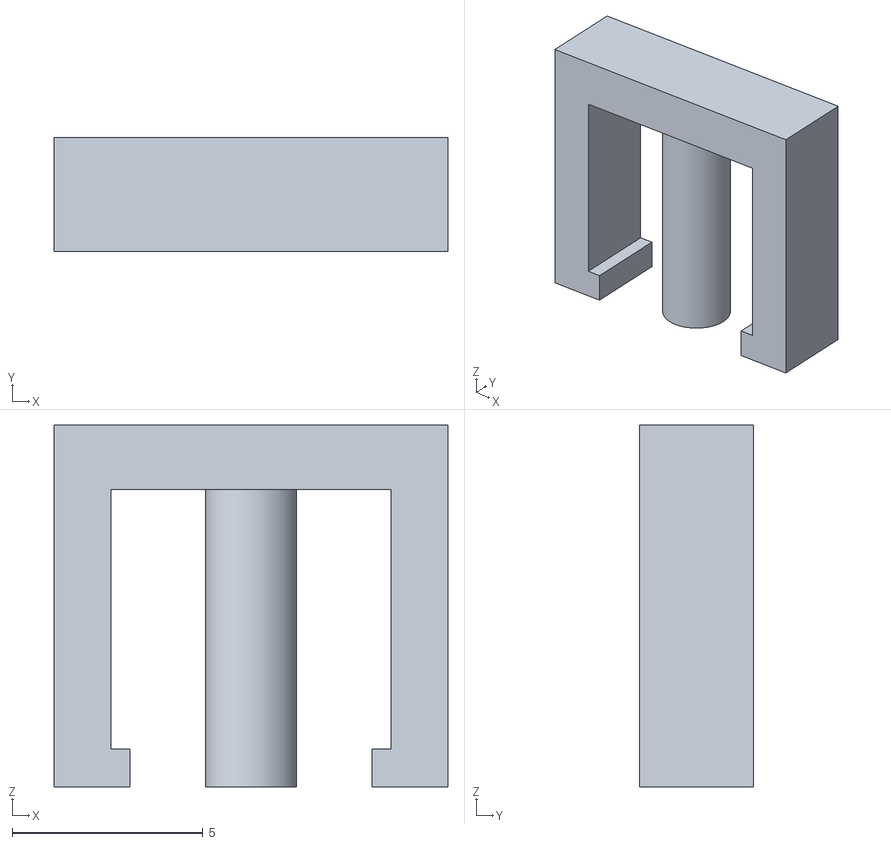
[picture p105: CAD file, 2020-11-13]
3Dprint/radhouder_v2/clip_p_2.stl
10.3 x 3.00 x 9.50
