dplars/TWI/3Dprint/radhouder_v2/radhouder_V2_clip.stl

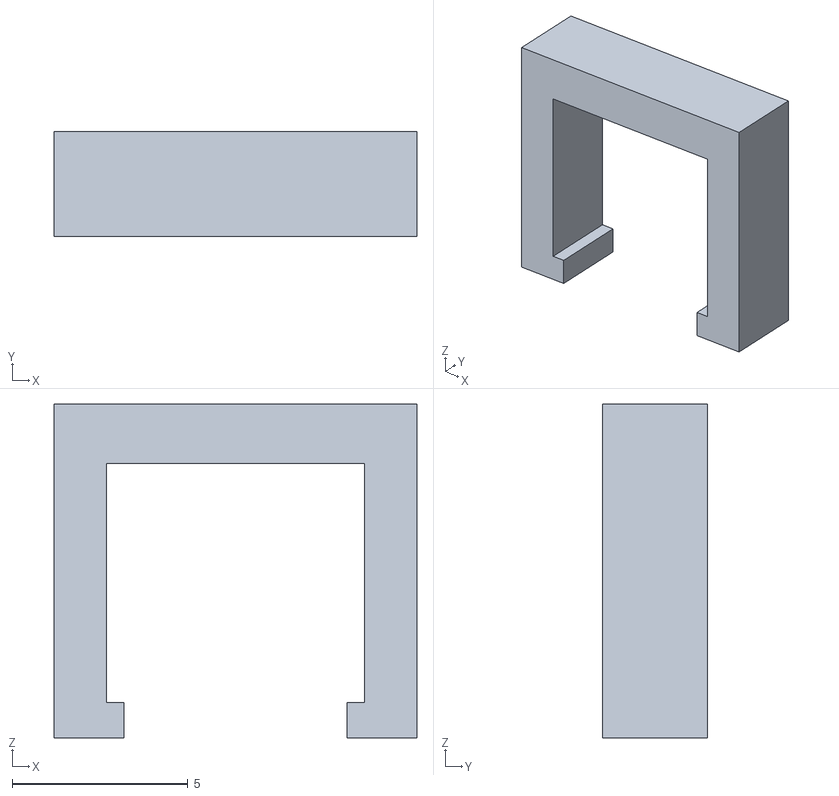
[picture p106: CAD file, 2020-11-13]
3Dprint/radhouder_v2/radhouder_V2_clip.stl
10.3 x 3.00 x 9.50
