dplars/TWI/3Dprint/microscoophouder/2020_klem.stl

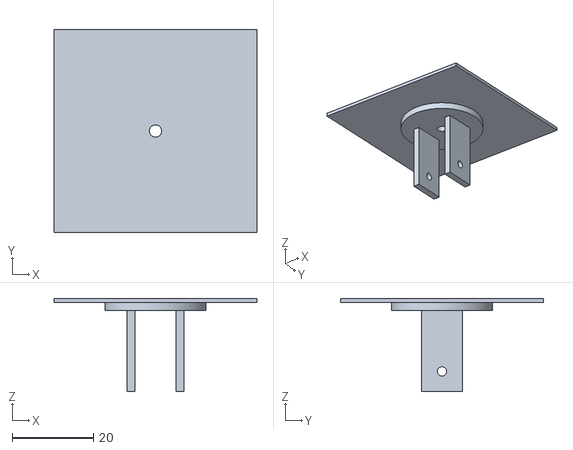
[picture p107: CAD file, 2020-12-02]
3Dprint/microscoophouder/2020_klem.stl
50.0 x 50.0 x 23.0
