dplars/TWI/3Dprint/microscoophouder/2020_uniform_X_shape_with_half_support.stl

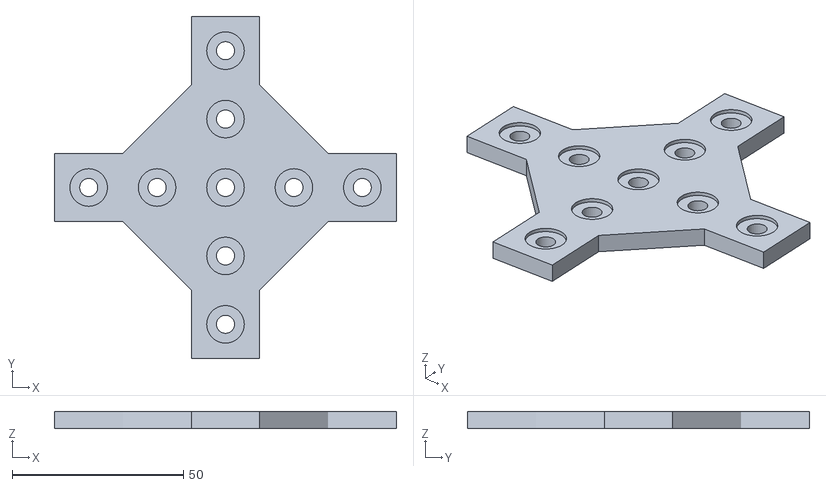
[picture p108: CAD file, 2020-12-02]
3Dprint/microscoophouder/2020_uniform_X_shape_with_half_support.stl
100.0 x 100.0 x 5.00
