dplars/TWI/3Dprint/radhouder_v2/clip_p.stl

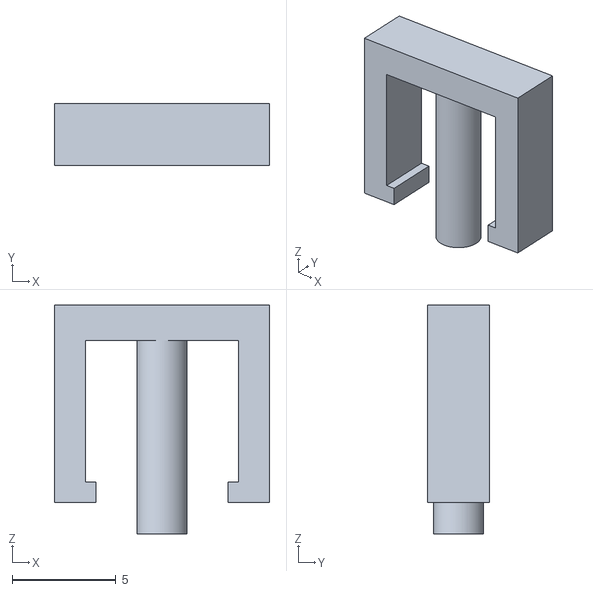
[picture p109: CAD file, 2020-11-13]
3Dprint/radhouder_v2/clip_p.stl
10.3 x 3.00 x 11.0
