dplars/TWI/3Dprint/microscoophouder/camera_houder_draai_mount_2.stl

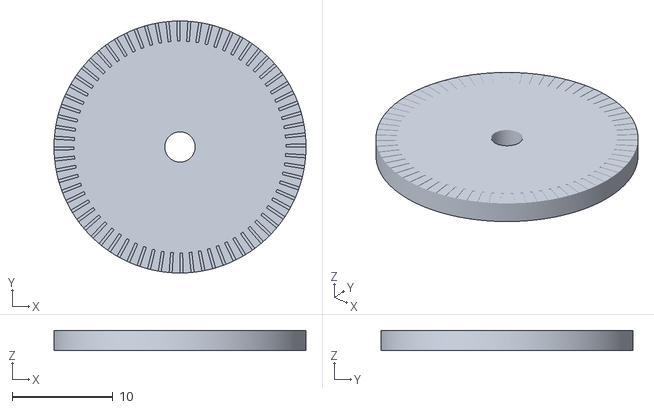
[picture p110: CAD file, 2020-12-02]
3Dprint/microscoophouder/camera_houder_draai_mount_2.stl
25.0 x 25.0 x 2.00
