dplars/TWI/3Dprint/microscoophouder/2020_camera houder_4.stl

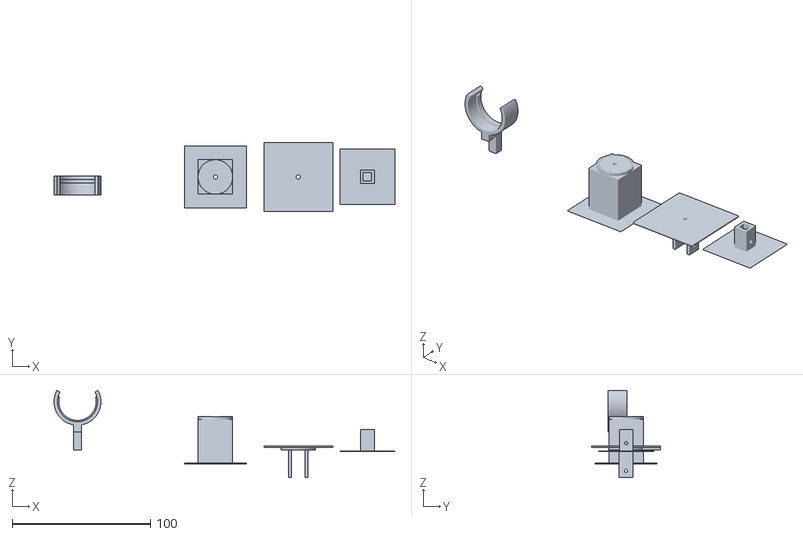
[picture p111: CAD file, 2020-12-02]
3Dprint/microscoophouder/2020_camera houder_4.stl
246.9 x 50.0 x 63.3
