dplars/TWI/3Dprint/microscoophouder/camera_houder_klem_houder.stl

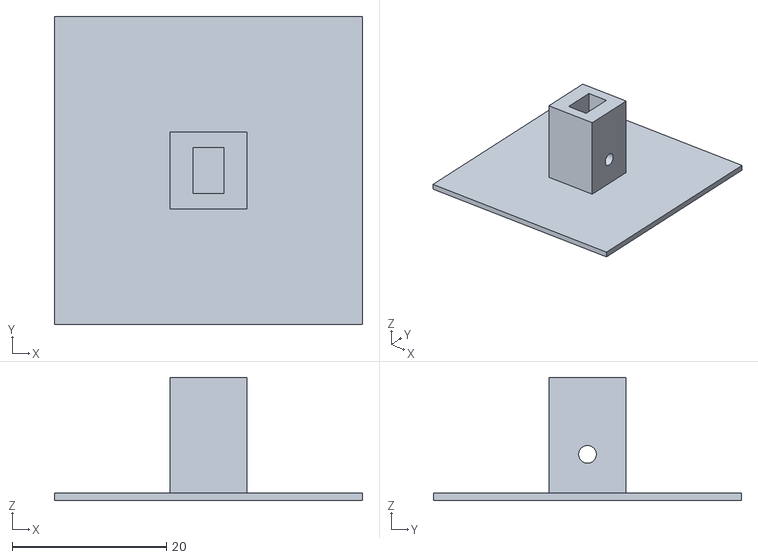
[picture p112: CAD file, 2020-12-02]
3Dprint/microscoophouder/camera_houder_klem_houder.stl
40.0 x 40.0 x 16.0
