dplars/TWI/3Dprint/microscoophouder/microscoophouder.stl

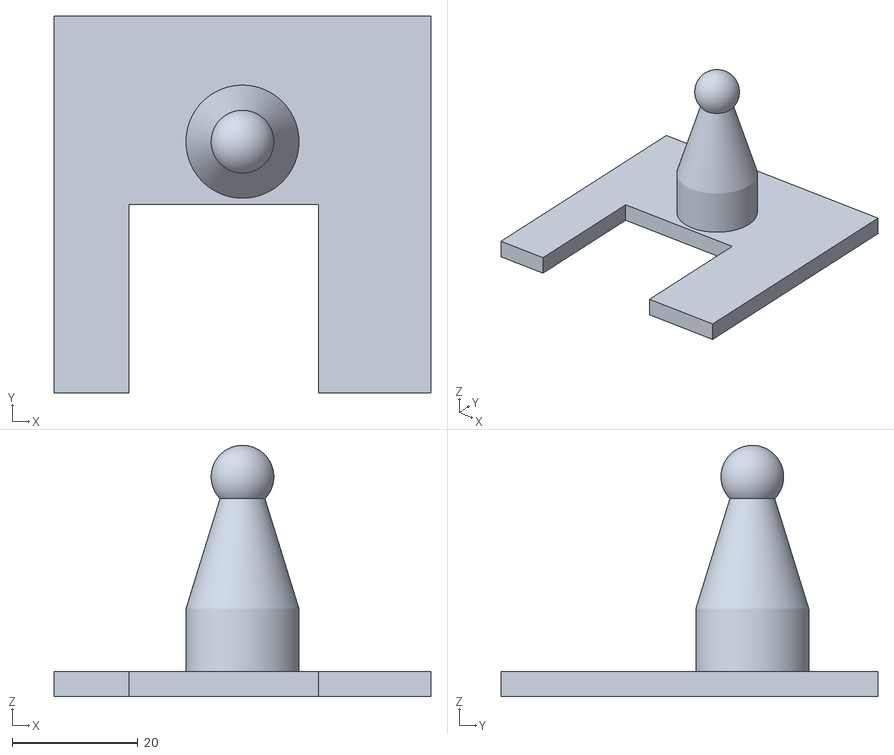
[picture p113: CAD file, 2020-11-13]
3Dprint/microscoophouder/microscoophouder.stl
60.0 x 60.0 x 40.0
