dplars/TWI/(list of files, cad)

Other CAD files:
3Dprint/setup/nema-17-22.snapshot.3/Holder nema17 grav.STL
3Dprint/radhouder_v2/radhouder_v2_num.stl
3Dprint/microscoophouder/camera_houder_5.stl
3Dprint/radhouder_v2/radhouder_V2_midc.stl
3Dprint/microscoophouder/camera_houder_klem_houder_4.stl
3Dprint/2020_profile/2020-aluminum-profile-1.snapshot.2/PROFILE_20х20.SLDPRT
3Dprint/camera/USB Microscope_Generic/USB Microscope_Generic.igs
3Dprint/radhouder/houder.stl
3Dprint/radhouder/houder2.stl
3Dprint/radhouder/houder3.stl
3Dprint/radhouder/houder4.stl
3Dprint/radhouder/houder5.stl
3Dprint/radhouder/houder6.stl
3Dprint/radhouder/houder7.stl
3Dprint/radhouder_v2/radhouder_V2.stl
