dplars/TWI/LaTeX/TussenTijdsVerslag/TexMaker/afkortingen.tex

\chapter*{List of Acronyms}
\addcontentsline{toc}{chapter}{List of abbreviations}

\begin{table}[!h]
	\begin{tabular}{cll}
		$CNN$ & Convolutional Neural Network \\
		$GPU$ & Graphics Processing Unit \\
		$LED$ & Light Emitting Diode\\
		$SSD-CNN$ & Small Data Driven Convolutional Neural Network \\
		$SGD$ & Stochastic Gradient descend \\
		$TL$ & Transfer Learning \\
		$wandb$ & Weights and Biases \\
		$WC$ & Wolfram Carbide \\
		
	\end{tabular}
\end{table}
