dplars/TWI/zim/Vision/GoogleColab/Test_Camera_Setup.txt

Content-Type: text/x-zim-wiki
Wiki-Format: zim 0.6
Creation-Date: 2020-11-04T15:32:01+01:00

====== Test Camera Setup ======
Created woensdag 04 november 2020

To test the camera setup, a binary classification model is made. This model will tell with a treshold of 150 (200 the real treshold but 150 to warn before tool is worn out) wether a tool is good to work with or must be removed from the machine. 
This model should be trainable with as less images as possible, preferably 20 because that is the amount of pictures taken in one batch.

===== [[+Resnet18|Resnet18]] =====
First we will try to implement SDD-Resnet18 to classify the few images in good or bad. 

===== [[+inception v3|inception v3]] =====
Than we will implement SDD-inception v3 

These described models should perform rather good without any transfer learning. 
After the first tests these results can be compared with a transfer learning model.

===== [[Vision:GoogleColab:Test Camera Setup:All Networks|All Networks]] =====
For this all networks test, some networks where tested and an algorithm is created to make it possible to add more networks along the way
