dplars/TWI/LaTeX/TussenTijdsVerslag/FromZim/Camera_setup/Light.tex

\documentclass{scrartcl}
\usepackage[mathletters]{ucs}
\usepackage[utf8x]{inputenc}
\usepackage{amssymb}
\usepackage{amsmath}
\usepackage[usenames]{color}
\usepackage{hyperref}
\usepackage{wasysym}
\usepackage{graphicx}
\usepackage[normalem]{ulem}
\usepackage{enumerate}

\usepackage{listings}

\lstset{ %
basicstyle=\footnotesize,       % the size of the fonts that are used for the code
showspaces=false,               % show spaces adding particular underscores
showstringspaces=false,         % underline spaces within strings
showtabs=false,                 % show tabs within strings adding particular underscores
frame=single,                   % adds a frame around the code
tabsize=2,                      % sets default tabsize to 2 spaces
breaklines=true,                % sets automatic line breaking
breakatwhitespace=false,        % sets if automatic breaks should only happen at whitespace
}

\title{Light}
\date{dinsdag 08 december 2020}
\author{}

\begin{document}

\maketitle

		\section{Light}

Created zaterdag 24 oktober 2020

Different light setups:

\begin{enumerate}[1]
\item \href{./Light/Desk_Lamp_Test.tex}{Desk Lamp}
\item \href{./Light/White_Led_Strips.tex}{+White\_Led\_Strips} white led strips (long) 
\item \href{./Light/Adressable_Color_Changeable_Led_Strip.tex}{+Adressable Color Changeable Led Strip}  led strip (single led)
\item Color changeable led strip (multiple combined in a matrix)
\item top light (white or colored)
\end{enumerate}

\end{document}
