dplars/TWI/LaTeX/TussenTijdsVerslag/TexMaker/private_oudestijl/back_fiiw_groupT_eng.pdf

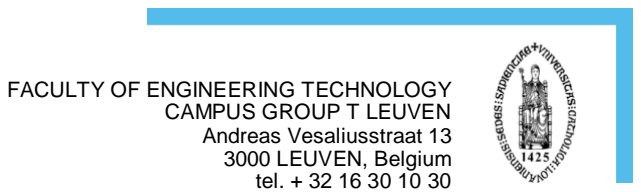
[picture p148: figure]
FACULTY OF ENGINEERING TECHNOLOGY CAMPUS GROUP T LEUVEN Andreas Vesaliusstraat 13 3000 LEUVEN, Belgium

tel. + 32 16 30 10 30
fax + 32 16 30 10 40
fet.groupt @kuleuven.be
www.fet.kuleuven.be
