dplars/TWI/LaTeX/TussenTijdsVerslag/TexMaker/bijlage1.tex

\chapter{Schedule}
 \begin{figure}[hbtp]
 \centering
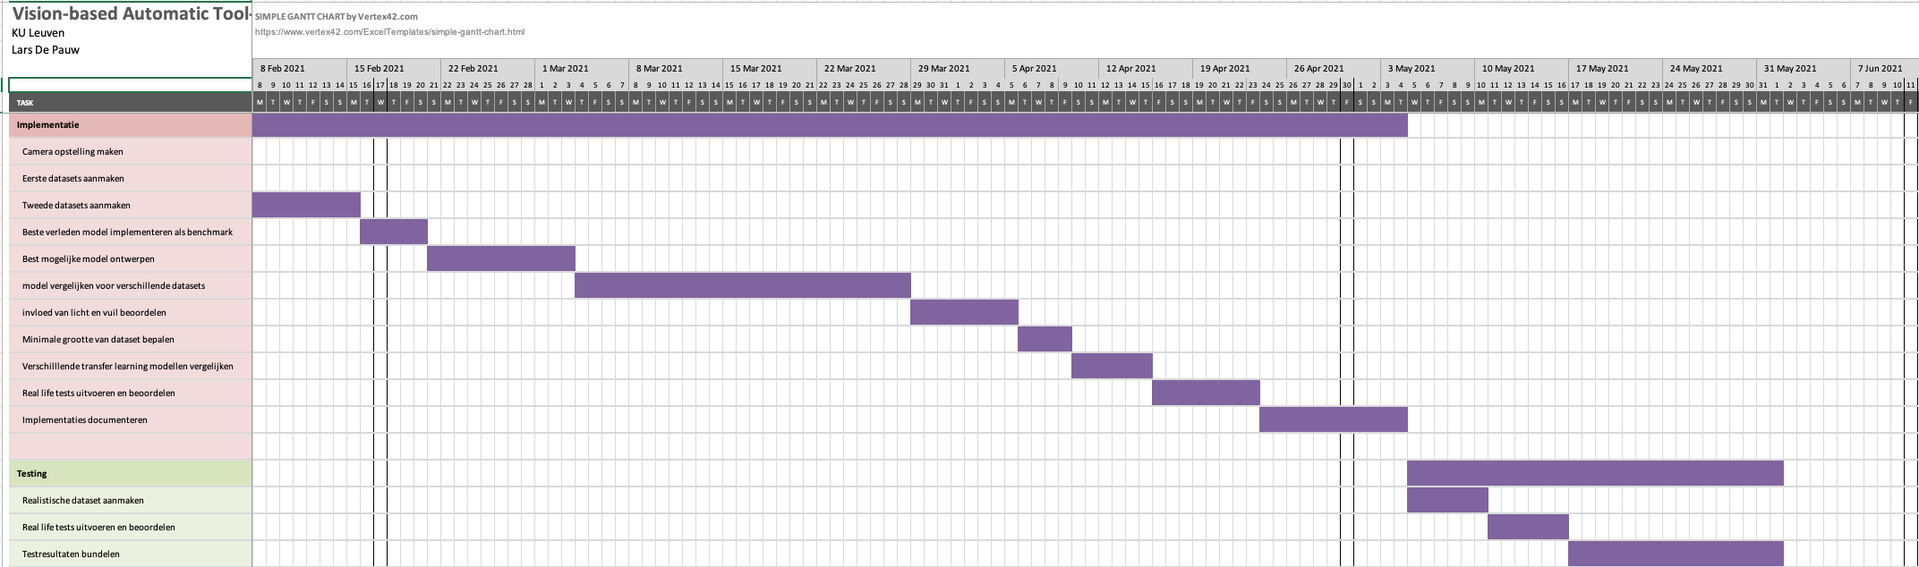
[picture p186: LaTeX/TussenTijdsVerslag/TexMaker/fig/algemeen/planning_sem2.png]
 
 \caption{Schedule for semester 2.}
 \end{figure}
