dplars/TWI/LaTeX/TussenTijdsVerslag/FromZim/Vision/GoogleColab/Test_Camera_Setup/All_Networks/All_Networks_3_Birthday.tex

\documentclass{scrartcl}
\usepackage[mathletters]{ucs}
\usepackage[utf8x]{inputenc}
\usepackage{amssymb}
\usepackage{amsmath}
\usepackage[usenames]{color}
\usepackage{hyperref}
\usepackage{wasysym}
\usepackage{graphicx}
\usepackage[normalem]{ulem}
\usepackage{enumerate}

\usepackage{listings}

\lstset{ %
basicstyle=\footnotesize,       % the size of the fonts that are used for the code
showspaces=false,               % show spaces adding particular underscores
showstringspaces=false,         % underline spaces within strings
showtabs=false,                 % show tabs within strings adding particular underscores
frame=single,                   % adds a frame around the code
tabsize=2,                      % sets default tabsize to 2 spaces
breaklines=true,                % sets automatic line breaking
breakatwhitespace=false,        % sets if automatic breaks should only happen at whitespace
}

\title{All Networks 3 Birthday}
\date{dinsdag 08 december 2020}
\author{}

\begin{document}

\maketitle

		\section{All Networks 3 Birthday}

Created vrijdag 04 december 2020

The code for this project is to be found here: \href{https://colab.research.google.com/drive/1_DKPtHi231TMalsj-uaBLytjcX2DuyV4#scrollTo=vmsTN_T4xoXP}{TSU\_AllNetworks\_3\_Birthday}

\end{document}
