dplars/TWI/LaTeX/TussenTijdsVerslag/FromZim/Vision/GoogleColab/Test_Camera_Setup/All_Networks/All_Networks_4_Spaghetti.tex

\documentclass{scrartcl}
\usepackage[mathletters]{ucs}
\usepackage[utf8x]{inputenc}
\usepackage{amssymb}
\usepackage{amsmath}
\usepackage[usenames]{color}
\usepackage{hyperref}
\usepackage{wasysym}
\usepackage{graphicx}
\usepackage[normalem]{ulem}
\usepackage{enumerate}

\usepackage{listings}

\lstset{ %
basicstyle=\footnotesize,       % the size of the fonts that are used for the code
showspaces=false,               % show spaces adding particular underscores
showstringspaces=false,         % underline spaces within strings
showtabs=false,                 % show tabs within strings adding particular underscores
frame=single,                   % adds a frame around the code
tabsize=2,                      % sets default tabsize to 2 spaces
breaklines=true,                % sets automatic line breaking
breakatwhitespace=false,        % sets if automatic breaks should only happen at whitespace
}

\title{All Networks 4 Spaghetti}
\date{dinsdag 08 december 2020}
\author{}

\begin{document}

\maketitle

		\section{All Networks 4 Spaghetti}

Created vrijdag 04 december 2020

The code for this can be found in here: \href{https://colab.research.google.com/drive/1kKCU9pAsVRqNR-lX1p45Z7BLTxp76CMq}{TSU\_AllNetworks\_4\_spaghetti}

The report is noted in \href{https://wandb.ai/dplars/pytorch-TWI_spaghetti_sweep/reports/Spaghetti-sweep-with-TSU_AllNetworks_4_spaghetti--VmlldzozNTIxNjM}{Spaghetti sweep with TSU\_AllNetworks\_4\_spaghetti} This can be transformed into latex without further problems i hope.

\end{document}
