dplars/TWI/LaTeX/TussenTijdsVerslag/TexMaker/private_oudestijl/cover_fiiw_bruges_eng.pdf

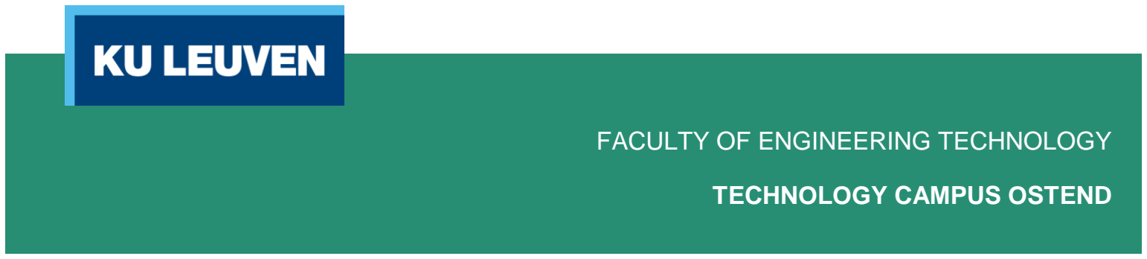
[picture p187: figure]
FACULTY OF ENGINEERING TECHNOLOGY; TECHNOLOGY CAMPUS OSTEND
