dplars/TWI/LaTeX/TussenTijdsVerslag/TexMaker/private_oudestijl/cover_fiiw_brugge.pdf

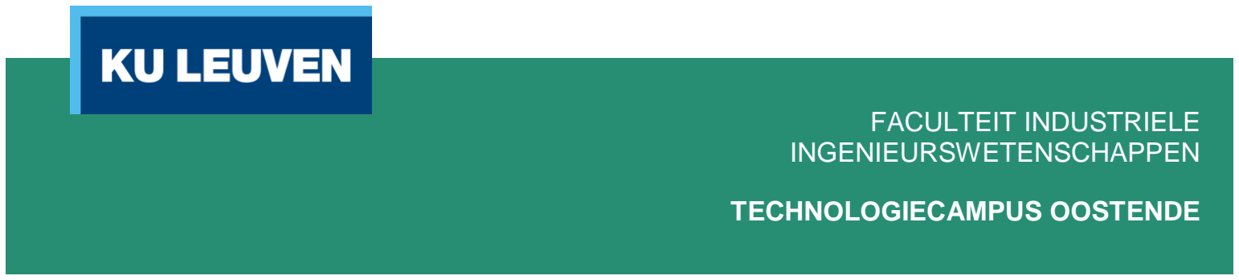
[picture p188: figure]
FACULTEIT INDUSTRIELE INGENIEURSWETENSCHAPPEN; TECHNOLOGIECAMPUS OOSTENDE
