dplars/TWI/LaTeX/TussenTijdsVerslag/TexMaker/private_oudestijl/cover_fiiw_denayer.pdf

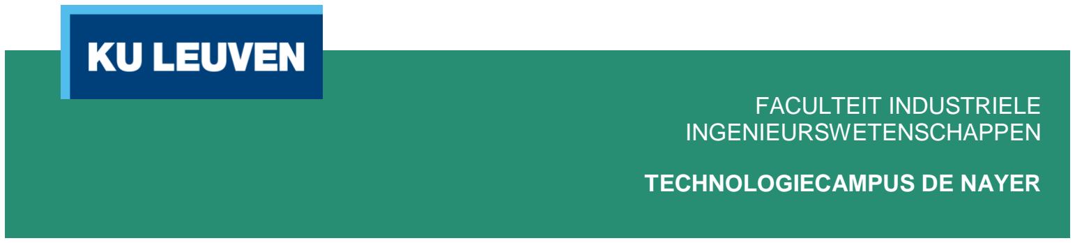
[picture p189: figure]
FACULTEIT INDUSTRIELE INGENIEURSWETENSCHAPPEN; TECHNOLOGIECAMPUS DE NAYER
