dplars/TWI/LaTeX/TussenTijdsVerslag/TexMaker/private_oudestijl/cover_fiiw_denayer_eng.pdf

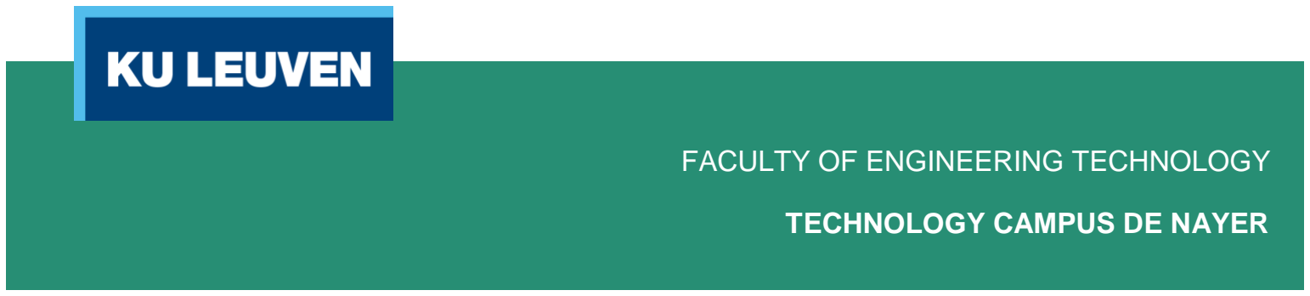
[picture p190: figure]
FACULTY OF ENGINEERING TECHNOLOGY; TECHNOLOGY CAMPUS DE NAYER
