dplars/TWI/LaTeX/TussenTijdsVerslag/TexMaker/private_oudestijl/cover_fiiw_geel.pdf

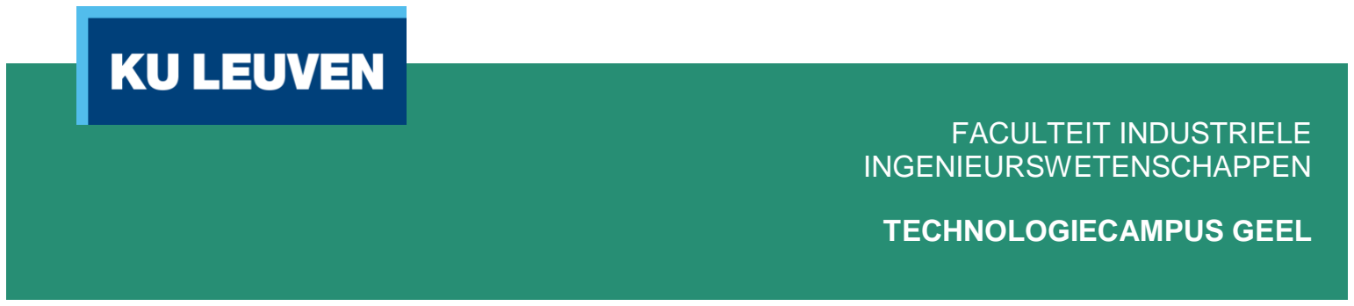
[picture p191: figure]
FACULTEIT INDUSTRIELE INGENIEURSWETENSCHAPPEN; TECHNOLOGIECAMPUS GEEL
