dplars/TWI/LaTeX/TussenTijdsVerslag/TexMaker/private_oudestijl/cover_fiiw_geel_eng.pdf

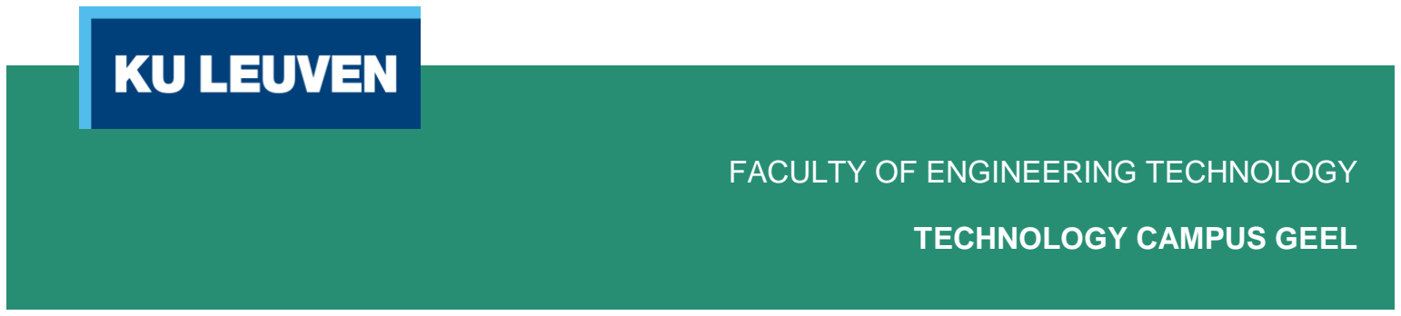
[picture p192: figure]
FACULTY OF ENGINEERING TECHNOLOGY; TECHNOLOGY CAMPUS GEEL
