dplars/TWI/LaTeX/TussenTijdsVerslag/TexMaker/private_oudestijl/cover_fiiw_groepT.pdf

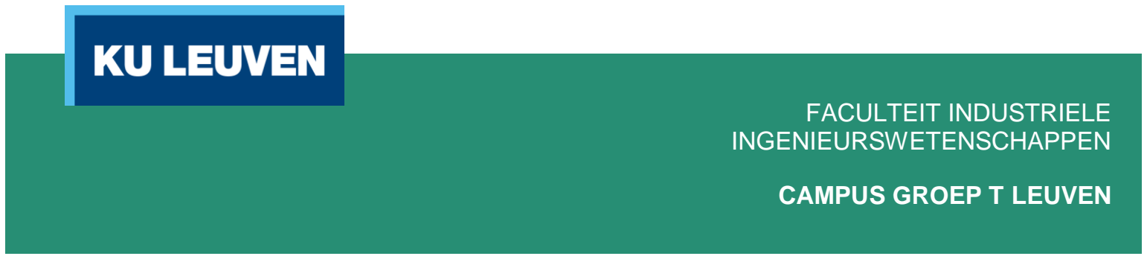
[picture p193: figure]
FACULTEIT INDUSTRIELE INGENIEURSWETENSCHAPPEN; CAMPUS GROEP T LEUVEN
