dplars/TWI/LaTeX/TussenTijdsVerslag/TexMaker/private_oudestijl/cover_fiiw_groupT_eng.pdf

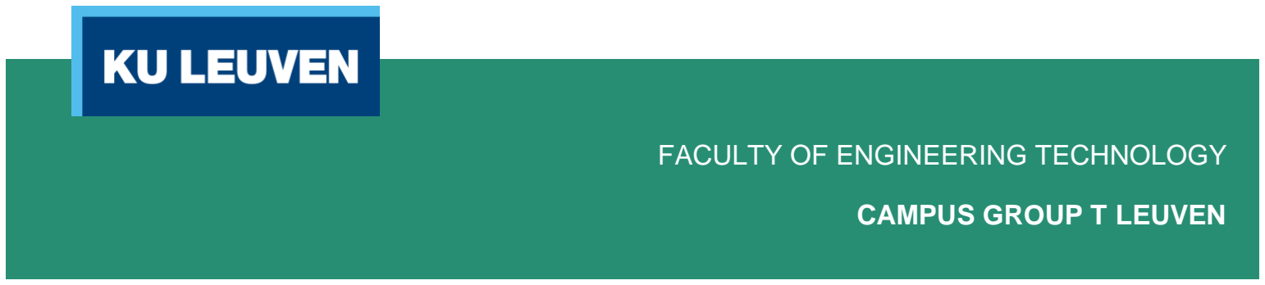
[picture p194: figure]
FACULTY OF ENGINEERING TECHNOLOGY; CAMPUS GROUP T LEUVEN
