dplars/TWI/code/Vision/wandb/TSU_AllNetworks_4_spaghetti/TestCameraSetup/data/spaghetti_dataset_sorted/white/valid/bad/b_017_p_006_l_006-011_white_nb.png

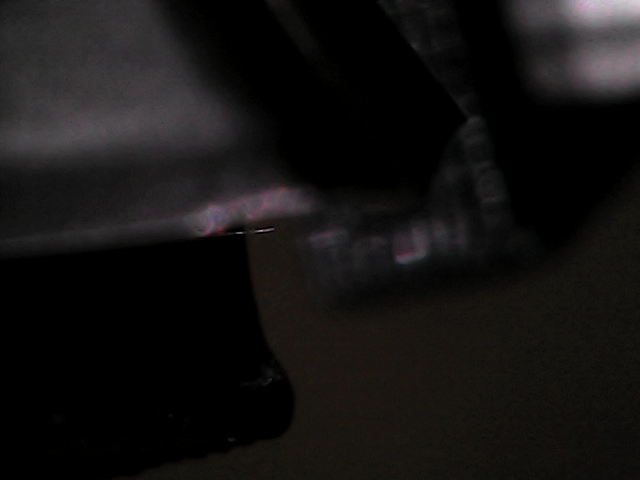
code/Vision/wandb/TSU_AllNetworks_4_spaghetti/TestCameraSetup/data/spaghetti_dataset_sorted/white/valid/bad/b_017_p_006_l_006-011_white_nb.png
