dplars/TWI/LaTeX/TussenTijdsVerslag/TexMaker/fig/algemeen/plaatjes/Figuren/WC_classification.jpg

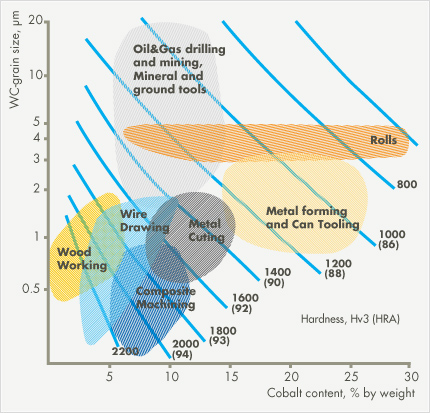
LaTeX/TussenTijdsVerslag/TexMaker/fig/algemeen/plaatjes/Figuren/WC_classification.jpg
