dplars/TWI/LaTeX/TussenTijdsVerslag/TexMaker/fig/algemeen/plaatjes/plaatje/n_wear_side_view.jpg

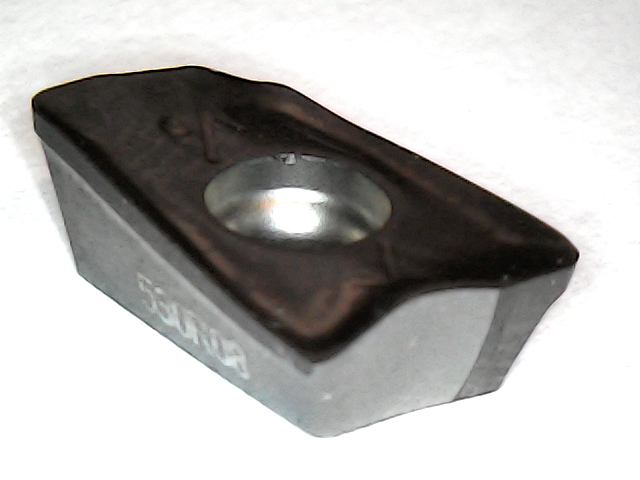
LaTeX/TussenTijdsVerslag/TexMaker/fig/algemeen/plaatjes/plaatje/n_wear_side_view.jpg
