dplars/TWI/LaTeX/TussenTijdsVerslag/TexMaker/fig/algemeen/plaatjes/plaatje/n_wear_side_view_warm.jpg

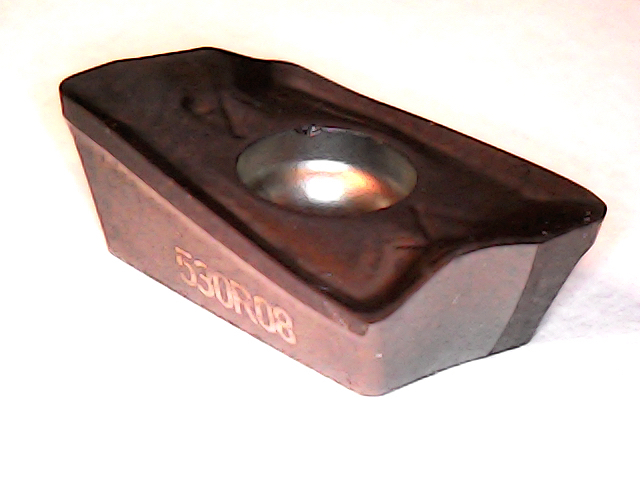
LaTeX/TussenTijdsVerslag/TexMaker/fig/algemeen/plaatjes/plaatje/n_wear_side_view_warm.jpg
