dplars/TWI/LaTeX/TussenTijdsVerslag/TexMaker/fig/algemeen/plaatjes/plaatje/plaatje_top_corner.jpeg

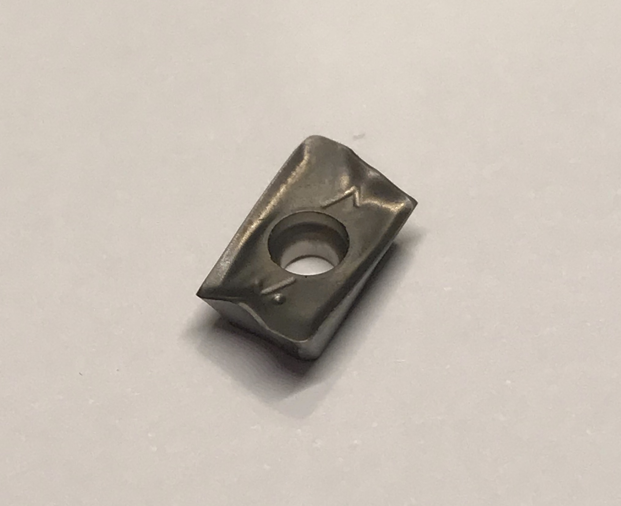
LaTeX/TussenTijdsVerslag/TexMaker/fig/algemeen/plaatjes/plaatje/plaatje_top_corner.jpeg
