dplars/TWI/LaTeX/TussenTijdsVerslag/TexMaker/fig/algemeen/plaatjes/plaatje/S20201214_001.jpg

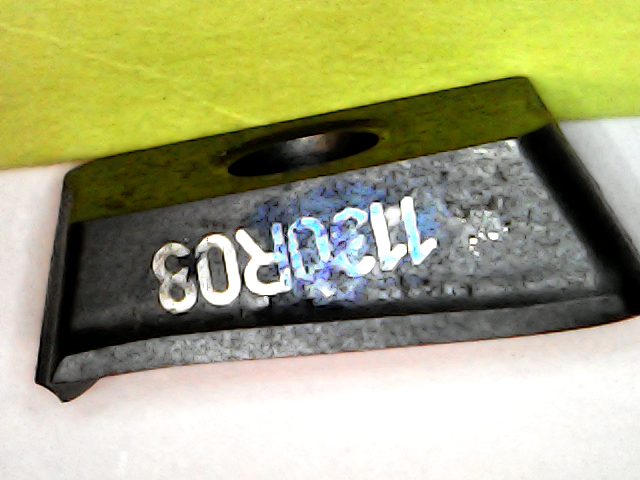
LaTeX/TussenTijdsVerslag/TexMaker/fig/algemeen/plaatjes/plaatje/S20201214_001.jpg
