dplars/TWI/LaTeX/TussenTijdsVerslag/TexMaker/fig/algemeen/plaatjes/plaatje/side_view.jpg

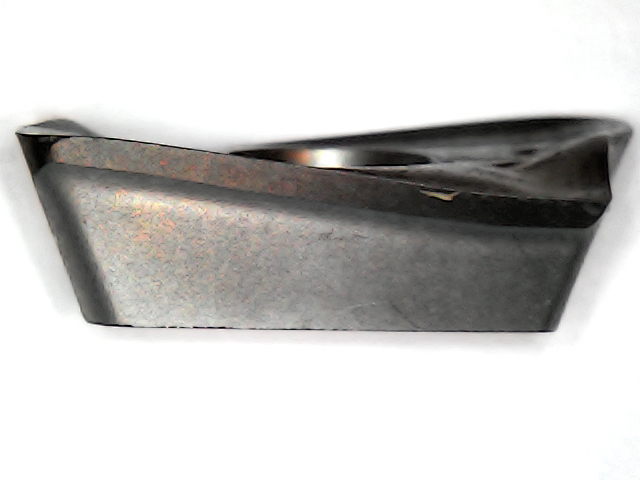
LaTeX/TussenTijdsVerslag/TexMaker/fig/algemeen/plaatjes/plaatje/side_view.jpg
