dplars/TWI/LaTeX/TussenTijdsVerslag/TexMaker/fig/algemeen/planning_sem2_v1.png

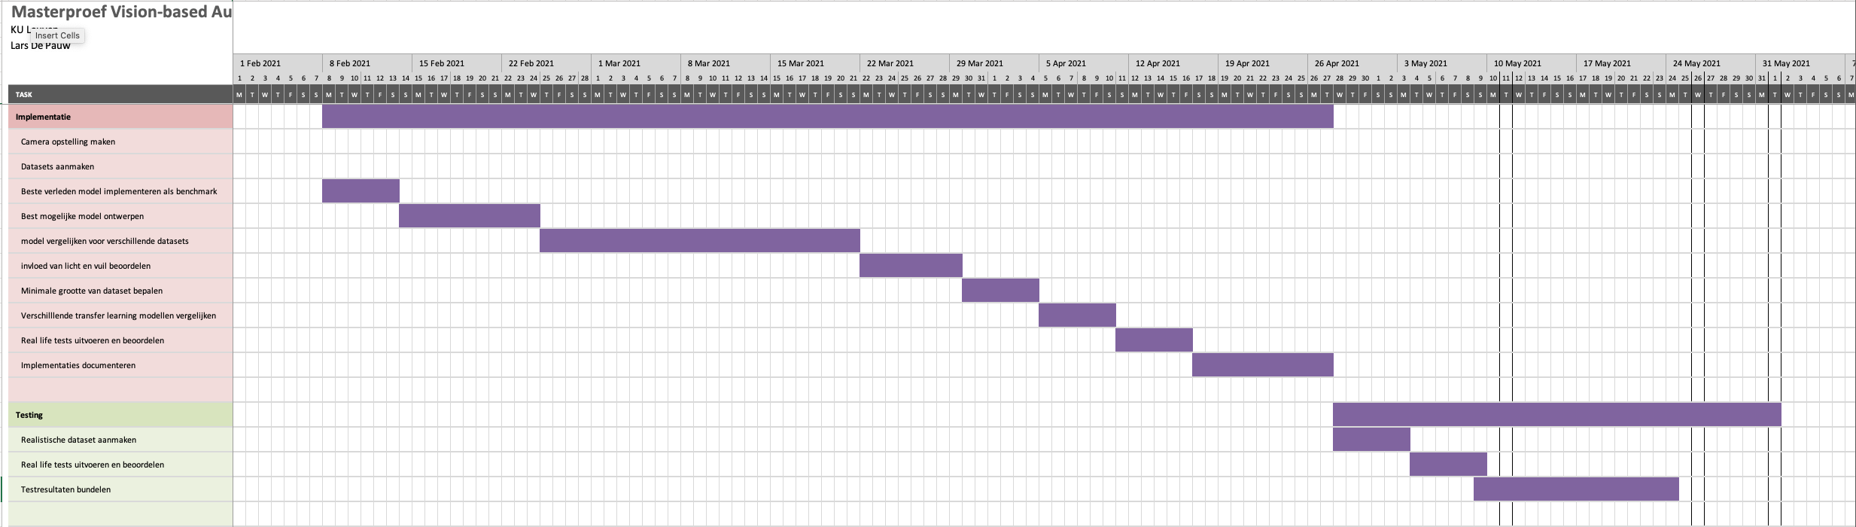
LaTeX/TussenTijdsVerslag/TexMaker/fig/algemeen/planning_sem2_v1.png
