dplars/TWI/LaTeX/TussenTijdsVerslag/TexMaker/fig/Camera_setup/Camera_mount/second_camera_mount/camera mount v9 top.png

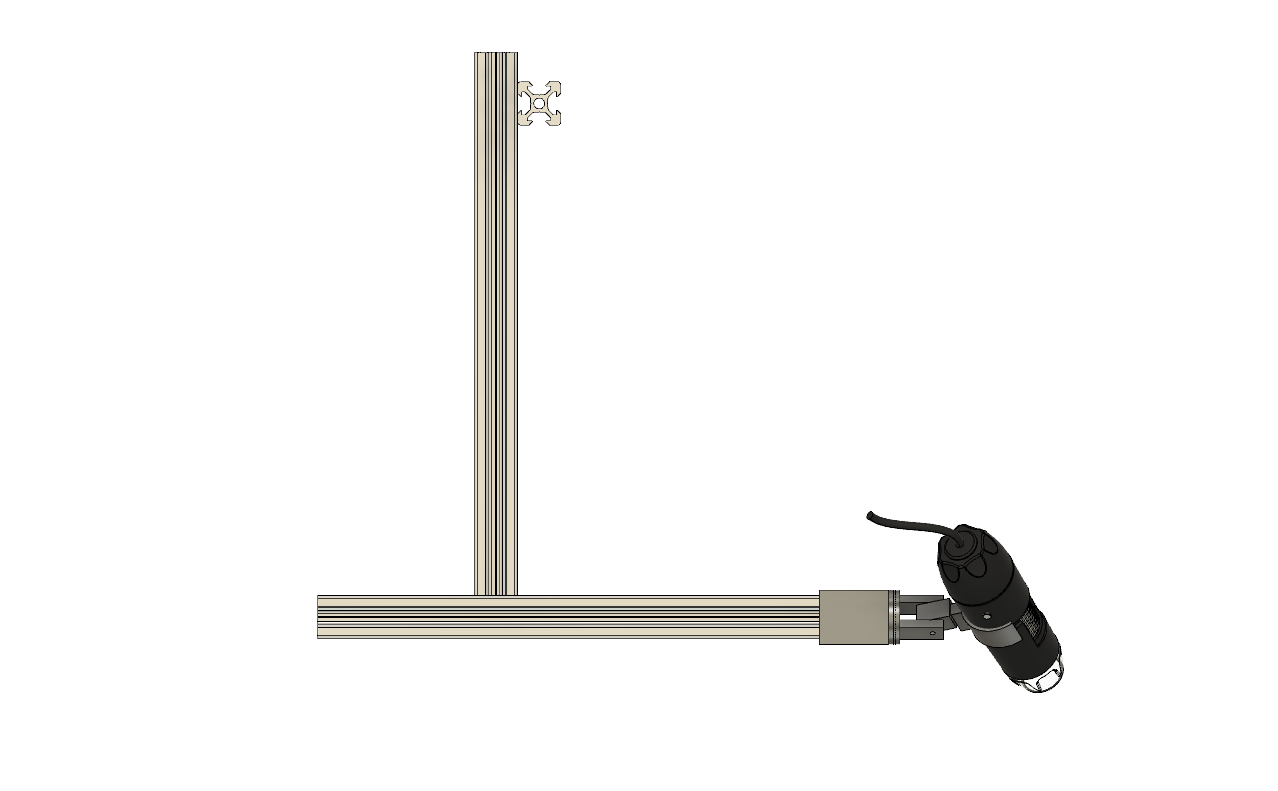
LaTeX/TussenTijdsVerslag/TexMaker/fig/Camera_setup/Camera_mount/second_camera_mount/camera mount v9 top.png
