dplars/TWI/LaTeX/TussenTijdsVerslag/TexMaker/fig/Camera_setup/model/camera mount v4.png

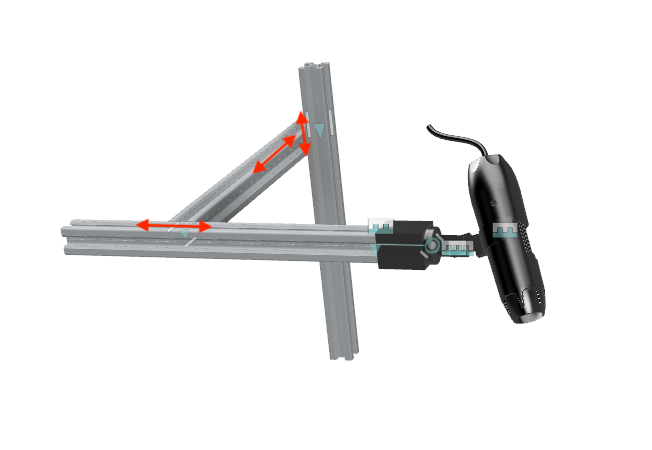
LaTeX/TussenTijdsVerslag/TexMaker/fig/Camera_setup/model/camera mount v4.png
