dplars/TWI/LaTeX/TussenTijdsVerslag/TexMaker/fig/Camera_setup/model/Full setup v4 back left top.png

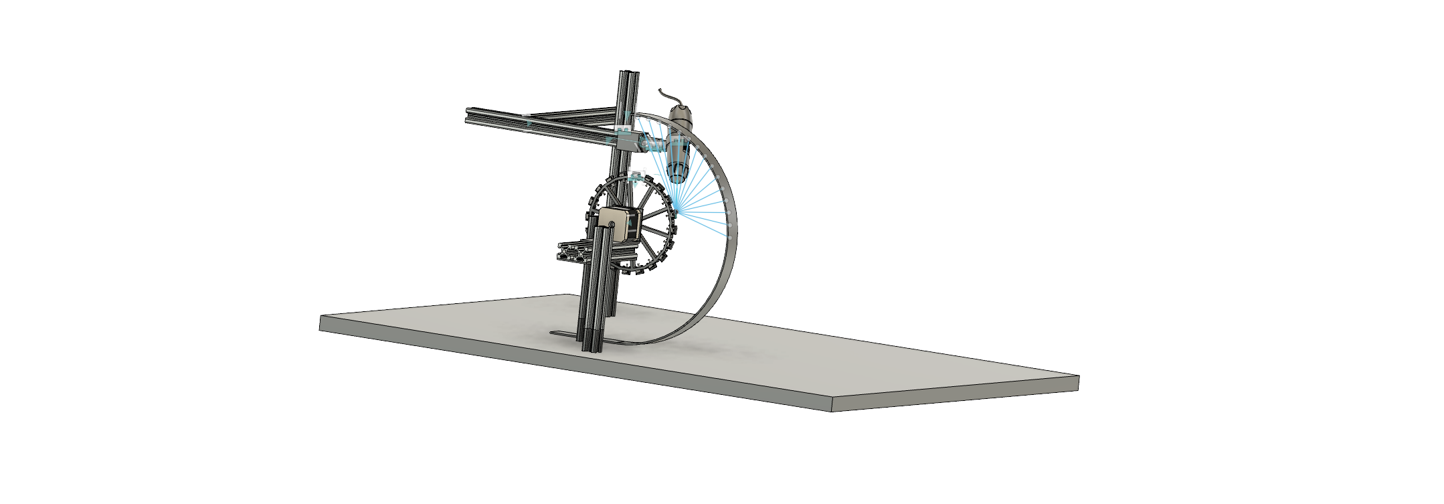
LaTeX/TussenTijdsVerslag/TexMaker/fig/Camera_setup/model/Full setup v4 back left top.png
