dplars/TWI/LaTeX/TussenTijdsVerslag/TexMaker/fig/Camera_setup/model/render/Full setup v12 back.png

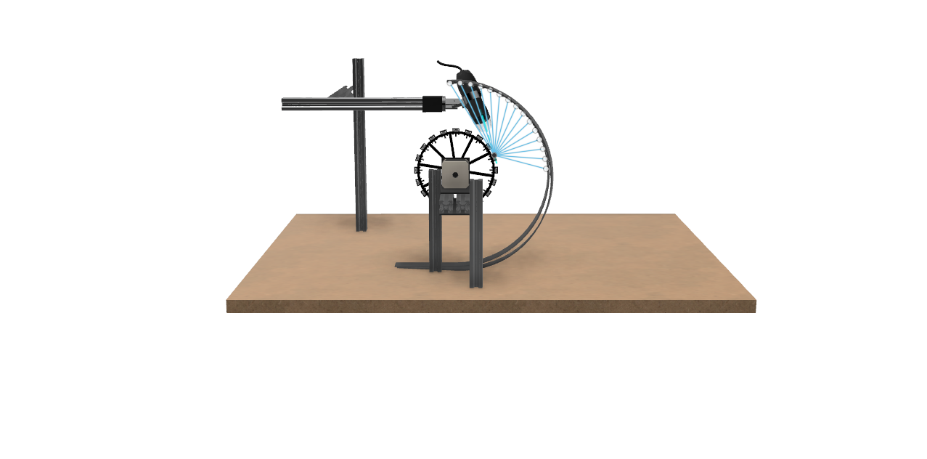
LaTeX/TussenTijdsVerslag/TexMaker/fig/Camera_setup/model/render/Full setup v12 back.png
