dplars/TWI/LaTeX/TussenTijdsVerslag/TexMaker/fig/Camera_setup/model/render/Full setup v12 front zoom.png

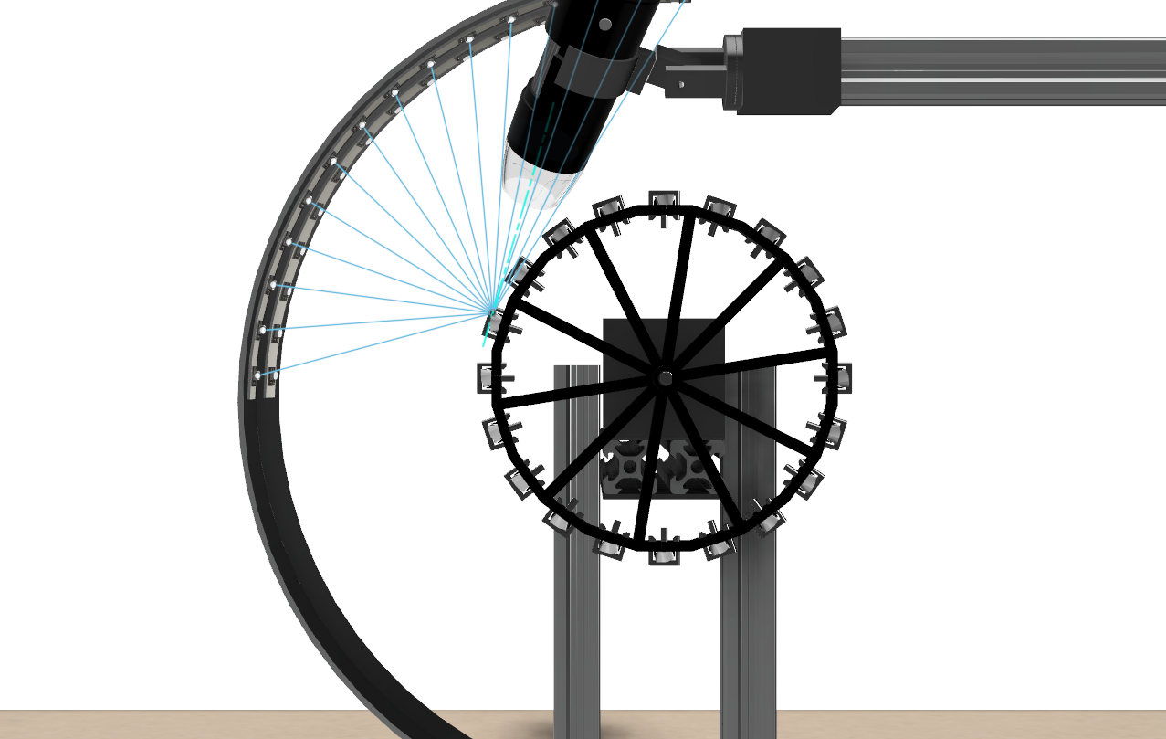
LaTeX/TussenTijdsVerslag/TexMaker/fig/Camera_setup/model/render/Full setup v12 front zoom.png
