dplars/TWI/LaTeX/TussenTijdsVerslag/TexMaker/fig/Camera_setup/model/render/Full setup v12 front.png

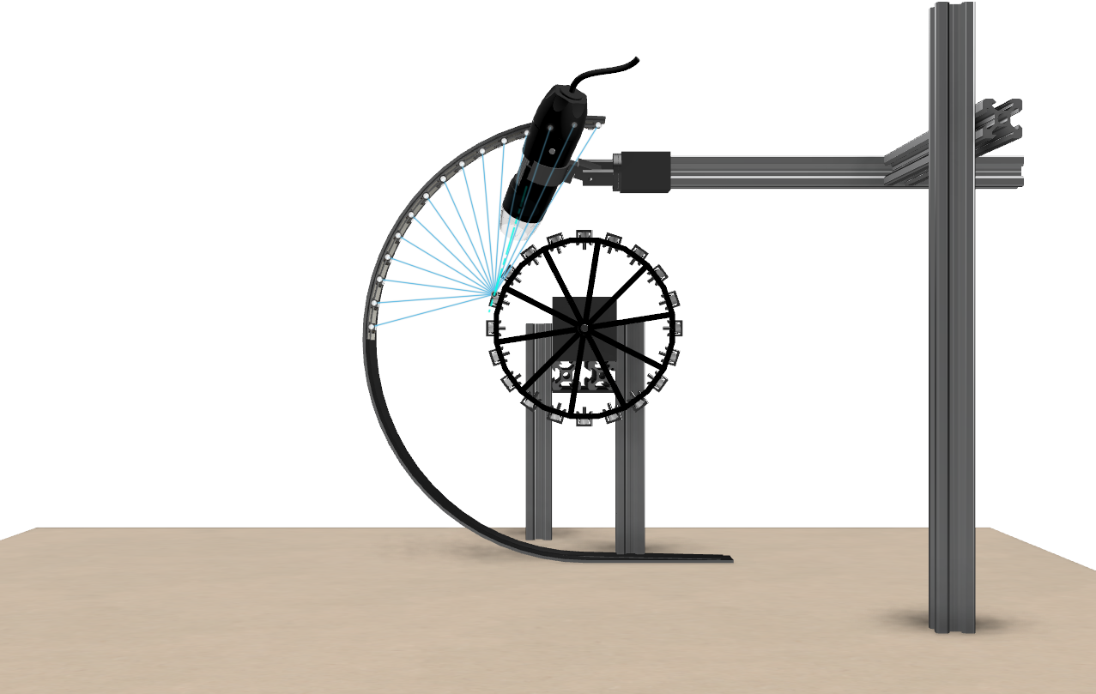
LaTeX/TussenTijdsVerslag/TexMaker/fig/Camera_setup/model/render/Full setup v12 front.png
