dplars/TWI/LaTeX/TussenTijdsVerslag/TexMaker/fig/Camera_setup/Tool_Holder/Wheel_Holder/first_wheel_holder/radhouderV1_model.png

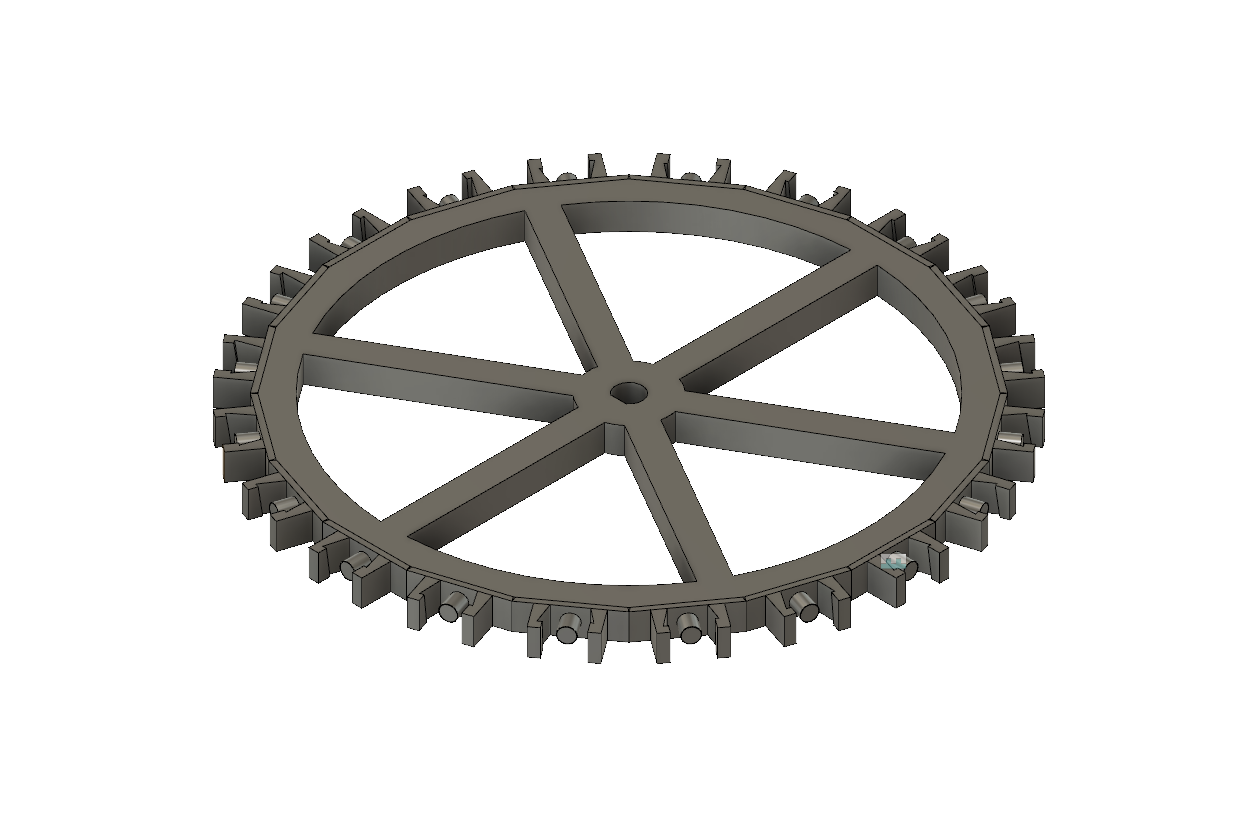
LaTeX/TussenTijdsVerslag/TexMaker/fig/Camera_setup/Tool_Holder/Wheel_Holder/first_wheel_holder/radhouderV1_model.png
