dplars/TWI/LaTeX/TussenTijdsVerslag/TexMaker/fig/Camera_setup/Tool_Holder/Wheel_Holder/Second_Wheel_Holder/radhouder_v2_assembly v3.png

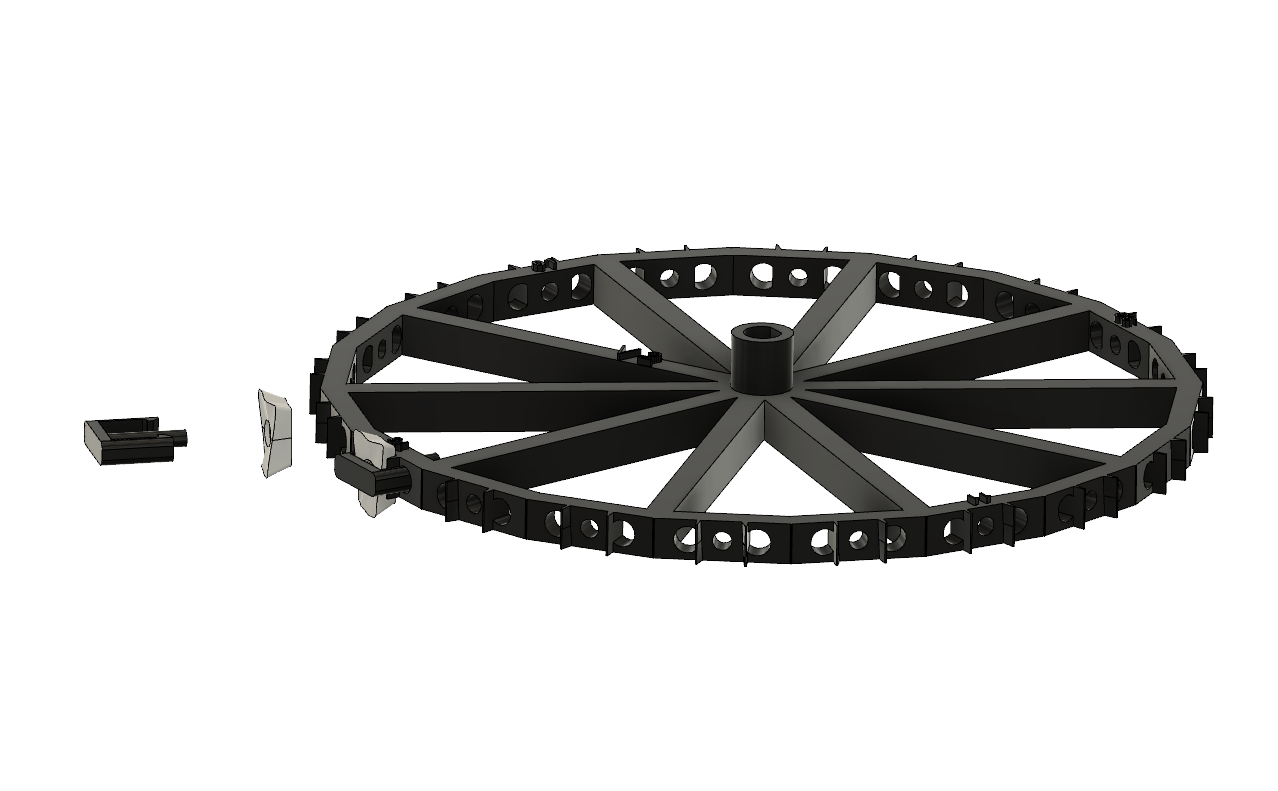
LaTeX/TussenTijdsVerslag/TexMaker/fig/Camera_setup/Tool_Holder/Wheel_Holder/Second_Wheel_Holder/radhouder_v2_assembly v3.png
