dplars/TWI/LaTeX/TussenTijdsVerslag/TexMaker/fig/Vision/Dataset/automated_datasets/2_created_datasets/2_Spaghetti_dataset/IMG_9298.jpeg

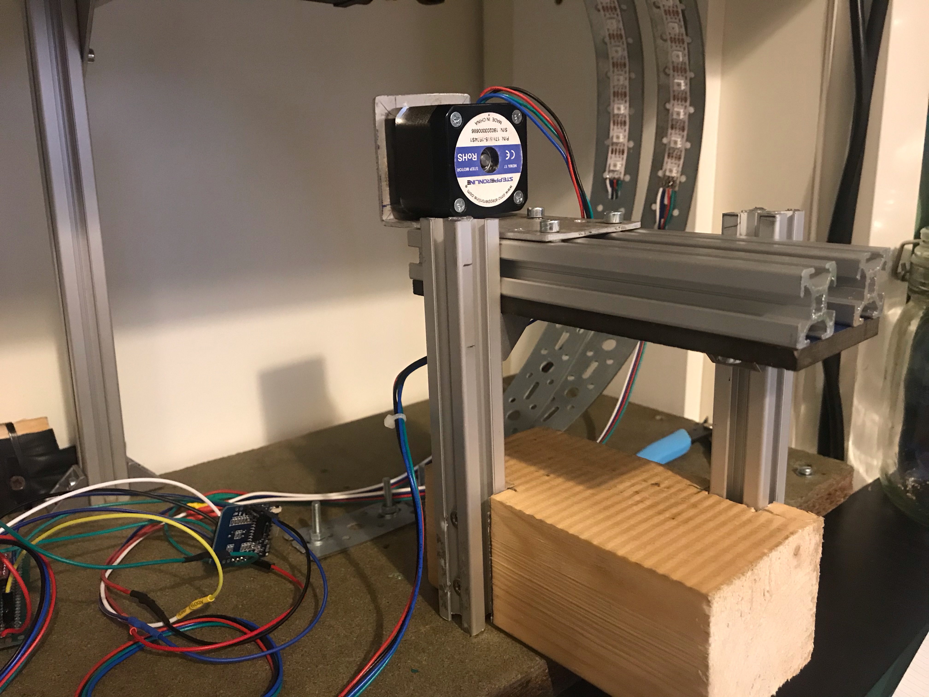
LaTeX/TussenTijdsVerslag/TexMaker/fig/Vision/Dataset/automated_datasets/2_created_datasets/2_Spaghetti_dataset/IMG_9298.jpeg
