dplars/TWI/code/Vision/Datasets/First_automated/testopstelling.rtf

First test setup with steel loops with two led strips of 15 leds mounted. White wheel first version on a stepper motor. camera mounted on opposite side of motor.

Tested with first python programm where always 1.5s delay is implemented.

camera_zij_dual_ledstrip_2:
taken with camera setup a little more to the side of the wheel;
the plates at an angle of 30 degrees when taken pictures;
automated shooting after the changes to the arduino files where the loop delay is countered.
