dplars/TWI/code/Vision/Datasets/second_automated/test_1/dataset_info.rtf

First test with new setup,
batch says 4 but is 1
plate numbers are correct

leds two by two on and off sepeately on the side with no bullet of the plates.
