dplars/TWI/code/Vision/Datasets/second_automated/test_2/dataset_info.rtf

dataset from batch 01 with plate 1;

failed run with to little information
two led strips at a time with different colors programmed
