dplars/TWI/code/Vision/Datasets/second_automated/test_3/dataset_info.rtf

first test with correct data with separate led strips and 4 colors, white, red, blue green
taken from the non bullet side

here batch number is wrong, must be 01 but is 04 should be changed in the next dataset
