dplars/TWI/code/Vision/Datasets/First_automated/camera_zij_dual_ledstrip_2/results.rtf

Setup
led lights same as other two datasets at an angle of about 7 degrees. -> distance between the leds 3 cm at the start of the ledstrips
taken with camera setup a little more to the side of the wheel;
the plates at an angle of 30 degrees when taken pictures;
automated shooting after the changes to the arduino files where the loop delay is countered.

Here is seen that the lighting is not reflected as much as on the setup where the camera is more to the top of the plate.
and the leds only light the worn surface at the end -> not much room for error so must be setup at an angle of 0° for better lighting conditions
