dplars/TWI/code/Vision/Datasets/First_automated/camera_zijkant_dual_ledstrip/test resultaten.rtf

test liep fout door niet lang genoeg te wachten voor commando’s uit te voeren, hierdoor zijn alle beelden zwart. Nog eens herhalen met de camera om te zien of de reflectie naar de zijkant toe beter is dan die naar boven.
