dplars/TWI/code/Vision/Datasets/First_automated/camera_zij_boven_dual_ledstrip/first_test/testresultaten.rtf

test gefaald gezien foto’s slecht werden weggeschreven, opgelost door meer tijd te geven aan arduino om leds aan te zetten en dan foto te nemen
