dplars/TWI/code/Vision/Datasets/First_automated/camera_zij_boven_dual_ledstrip/second_test/test resultaten.rtf

test beter, duurde zeer lang doordat timedelay op 1.5 moest ingesteld worden , voor volgende test timedelay verkleint en arduino code aangepast

-> timedelay op 1 werkt ook niet, ander probleem zien aan tepakken, misschien de communicatie snelheid naar de arduino, checken bij serial library hoe dat wordt ingesteld
