dplars/TWI/LaTeX/TussenTijdsVerslag/TexMaker/fig/results/wandb/second_handmade_sweep/runsets/Section-18-Table.csv

displayName | duration | host
Alexnet | 21184 | 903dccc3e0f3
Resnet18 | 36386 | 903dccc3e0f3
Squeezenet | 49960 | 3d61a212aad3
