dplars/TWI/LaTeX/TussenTijdsVerslag/TexMaker/fig/results/wandb/spaghetti_dataset/runsets/Section-16-Table.csv

displayName | duration | notes
white | 272758 | -
red | 272413 | -
