dplars/TWI/code/Vision/wandb/test/tsu_allnetworks_2/data/images/labels4.csv

batch number | plate number | imgname | imgnameext | stripe? | bullet? | value
001 | 001 | b_001_p_001_n | b_001_p_001_n.jpg | 0 |  | 50,73
001 | 001 | b_001_p_001_s | b_001_p_001_s.jpg | 1 | 001 | 57,122
001 | 002 | b_001_p_002_n | b_001_p_002_n.jpg | 0 |  | 46,985
001 | 002 | b_001_p_002_s | b_001_p_002_s.jpg | 1 | 001 | 68,904
001 | 003 | b_001_p_003_n | b_001_p_003_n.jpg | 0 | 001 | 35,349
001 | 003 | b_001_p_003_s | b_001_p_003_s.jpg | 1 |  | 32,594
001 | 004 | b_001_p_004_n | b_001_p_004_n.jpg | 0 | 001 | 38,79
001 | 004 | b_001_p_004_s | b_001_p_004_s.jpg | 1 |  | 47,354
001 | 005 | b_001_p_005_n | b_001_p_005_n.jpg | 0 |  | 42,637
001 | 005 | b_001_p_005_s | b_001_p_005_s.jpg | 1 | 1 | 44,159
001 | 006 | b_001_p_006_n | b_001_p_006_n.jpg | 0 |  | 40,958
001 | 006 | b_001_p_006_s | b_001_p_006_s.jpg | 1 | 1 | 40,505
001 | 007 | b_001_p_007_n | b_001_p_007_n.jpg | 0 | 1 | 34,71
001 | 007 | b_001_p_007_s | b_001_p_007_s.jpg | 1 |  | 44,46
001 | 008 | b_001_p_008_n | b_001_p_008_n.jpg | 0 | 1 | 75,51
001 | 008 | b_001_p_008_s | b_001_p_008_s.jpg | 1 |  | 37,775
001 | 009 | b_001_p_009_n | b_001_p_009_n.jpg | 0 | 001 | 39,883
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
