dplars/TWI/code/Vision/wandb/test/tsu_allnetworks_2/data/images/sorted/test/bad/b_003_p_002_s.jpg

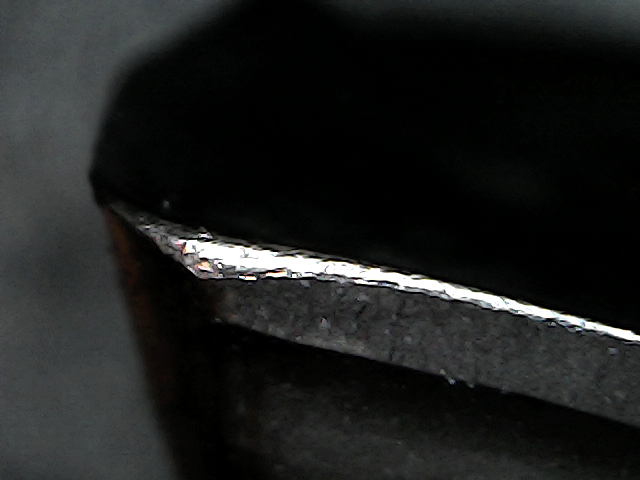
code/Vision/wandb/test/tsu_allnetworks_2/data/images/sorted/test/bad/b_003_p_002_s.jpg
