dplars/TWI/code/Vision/wandb/test/tsu_allnetworks_2/data/images/sorted/test/bad/b_004_p_004_n.jpg

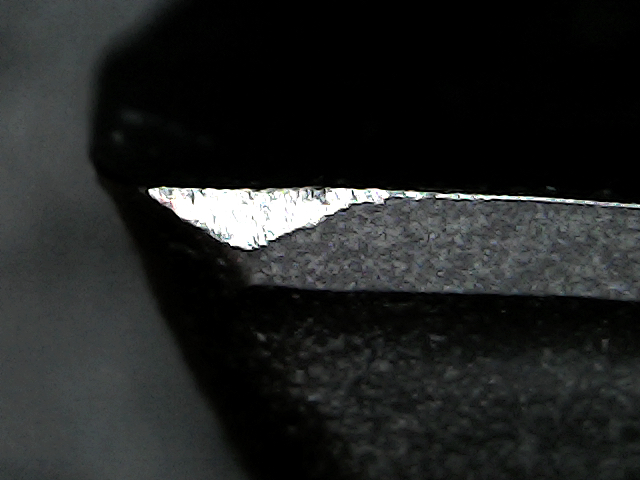
code/Vision/wandb/test/tsu_allnetworks_2/data/images/sorted/test/bad/b_004_p_004_n.jpg
