dplars/TWI/code/Vision/wandb/test/tsu_allnetworks_2/data/images/sorted/test/good/b_001_p_005_n.jpg

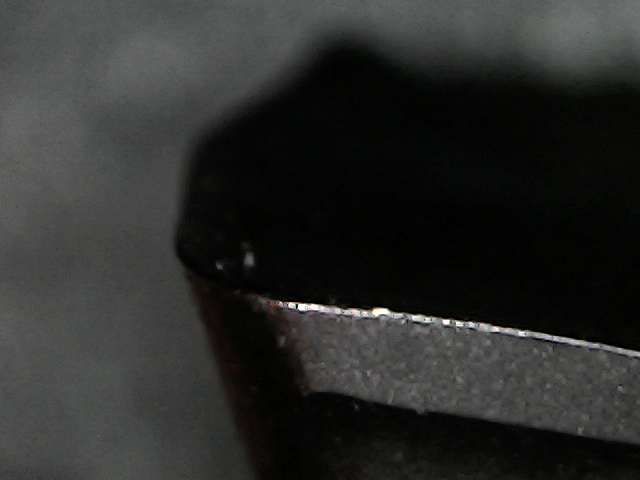
code/Vision/wandb/test/tsu_allnetworks_2/data/images/sorted/test/good/b_001_p_005_n.jpg
