dplars/TWI/code/Vision/wandb/test/tsu_allnetworks_2/data/images/sorted/test/good/b_002_p_007_s.jpg

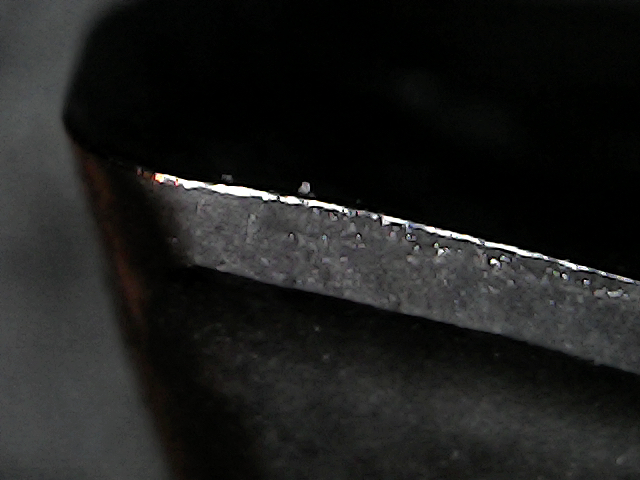
code/Vision/wandb/test/tsu_allnetworks_2/data/images/sorted/test/good/b_002_p_007_s.jpg
