dplars/TWI/code/Vision/wandb/test/tsu_allnetworks_2/data/images/sorted/train/bad/b_003_p_006_s.jpg

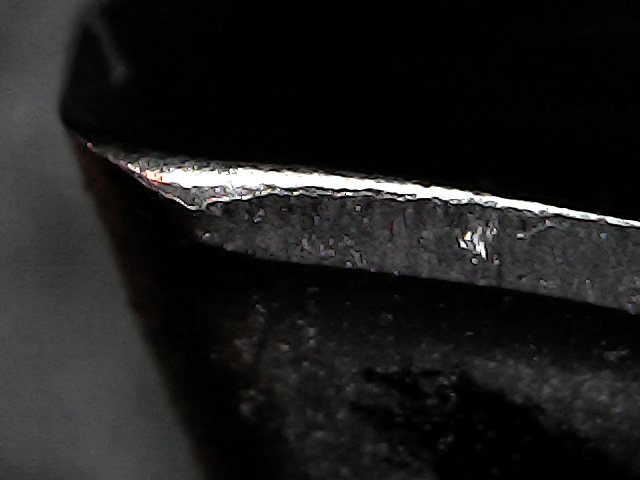
code/Vision/wandb/test/tsu_allnetworks_2/data/images/sorted/train/bad/b_003_p_006_s.jpg
