dplars/TWI/code/Vision/wandb/test/tsu_allnetworks_2/data/images/sorted/train/bad/b_004_p_002_n.jpg

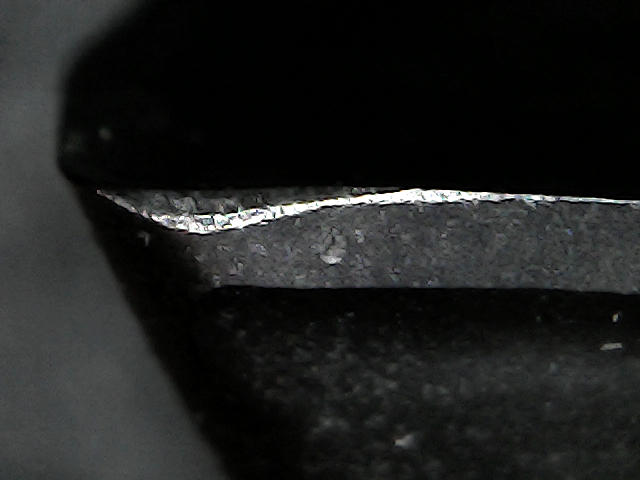
code/Vision/wandb/test/tsu_allnetworks_2/data/images/sorted/train/bad/b_004_p_002_n.jpg
