dplars/TWI/code/Vision/wandb/test/tsu_allnetworks_2/data/images/sorted/train/good/b_001_p_004_s.jpg

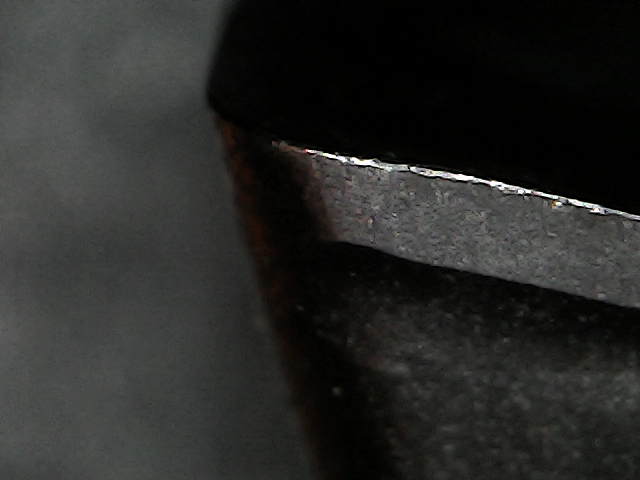
code/Vision/wandb/test/tsu_allnetworks_2/data/images/sorted/train/good/b_001_p_004_s.jpg
