dplars/TWI/code/Vision/wandb/test/tsu_allnetworks_2/data/images/sorted/train/medium/b_003_p_007_n.jpg

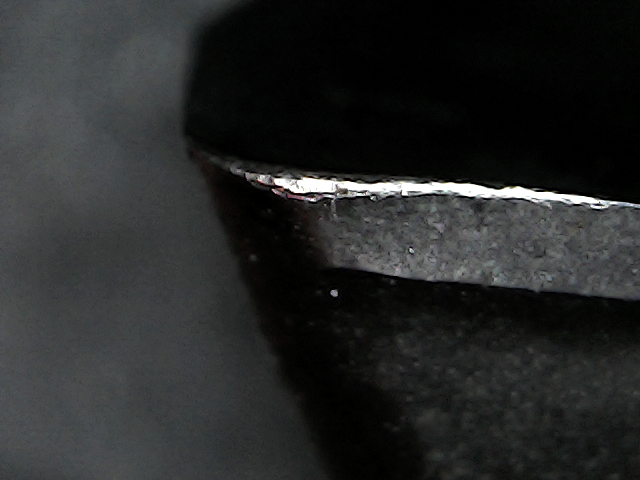
code/Vision/wandb/test/tsu_allnetworks_2/data/images/sorted/train/medium/b_003_p_007_n.jpg
