dplars/TWI/code/Vision/wandb/test/tsu_allnetworks_2/data/images/sorted/valid/bad/b_005_p_004_s.jpg

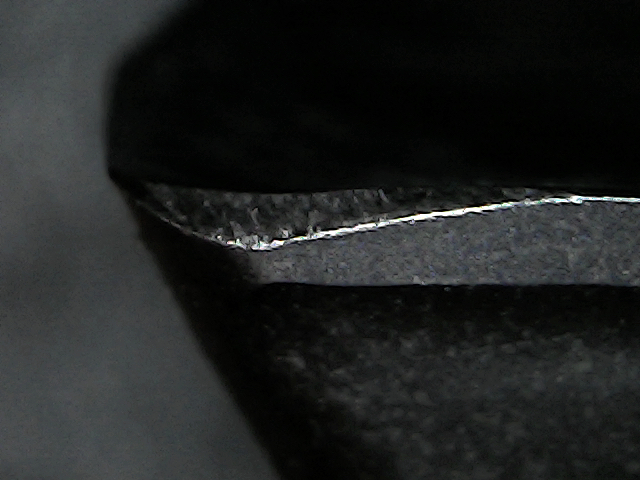
code/Vision/wandb/test/tsu_allnetworks_2/data/images/sorted/valid/bad/b_005_p_004_s.jpg
