dplars/TWI/code/Vision/wandb/test/tsu_allnetworks_2/data/images/sorted/valid/good/b_001_p_007_s.jpg

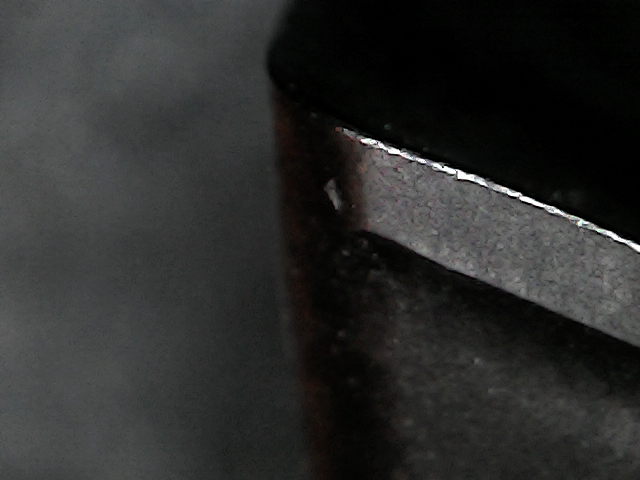
code/Vision/wandb/test/tsu_allnetworks_2/data/images/sorted/valid/good/b_001_p_007_s.jpg
