dplars/TWI/code/Vision/wandb/test/tsu_allnetworks_2/data/images/sorted/valid/medium/b_003_p_008_n.jpg

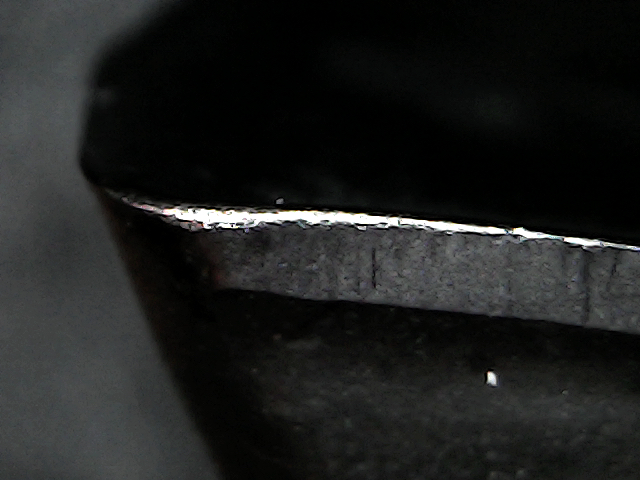
code/Vision/wandb/test/tsu_allnetworks_2/data/images/sorted/valid/medium/b_003_p_008_n.jpg
