dplars/TWI/code/Vision/wandb/test/tsu_allnetworks_2/data/images/sorted/valid/medium/b_003_p_010_s.jpg

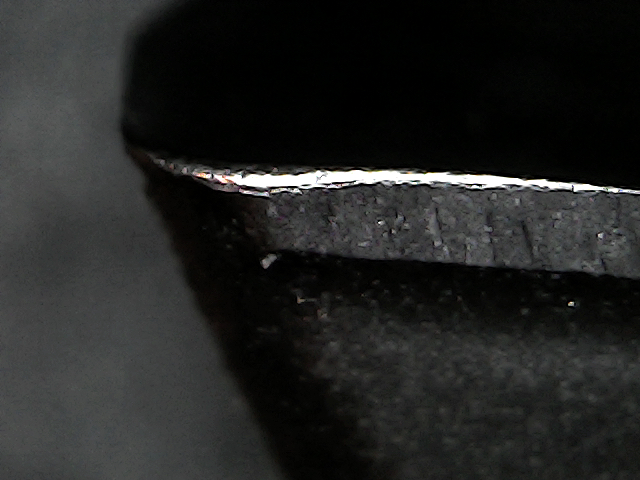
code/Vision/wandb/test/tsu_allnetworks_2/data/images/sorted/valid/medium/b_003_p_010_s.jpg
