dplars/TWI/code/Vision/wandb/test/tsu_allnetworks_2/data/images/sorted/valid/medium/b_004_p_001_s.jpg

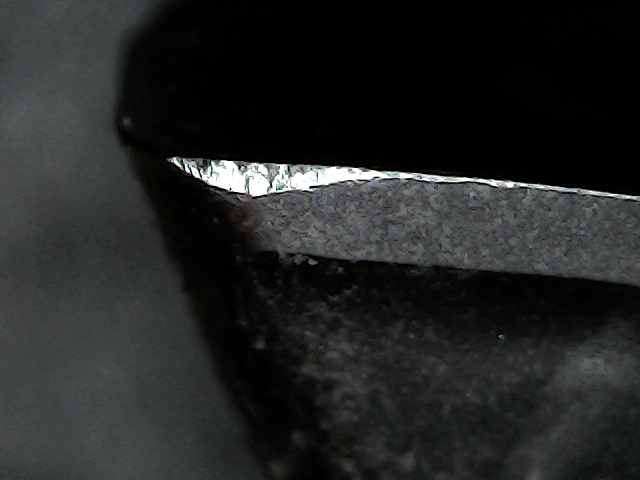
code/Vision/wandb/test/tsu_allnetworks_2/data/images/sorted/valid/medium/b_004_p_001_s.jpg
