dplars/TWI/code/Vision/wandb/TSU_AllNetworks_4_spaghetti/TestCameraSetup/data/spaghetti_dataset_sorted/red/test/bad/b_011_p_001_l_006-011_red_nb.png

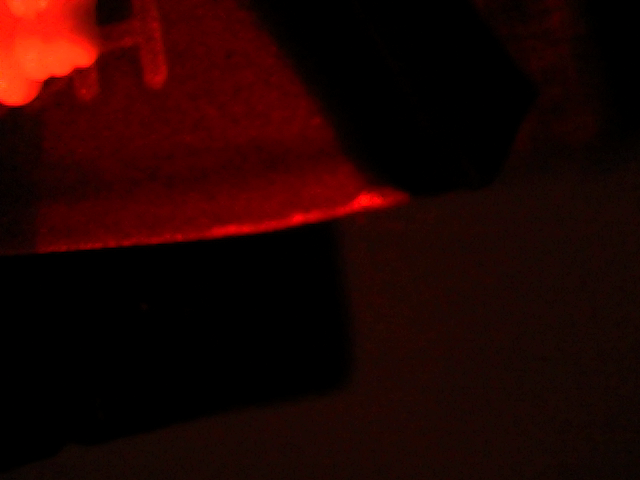
code/Vision/wandb/TSU_AllNetworks_4_spaghetti/TestCameraSetup/data/spaghetti_dataset_sorted/red/test/bad/b_011_p_001_l_006-011_red_nb.png
