dplars/TWI/LaTeX/TussenTijdsVerslag/TexMaker/fig/results/wandb/second_handmade_sweep/charts/Section-6-Panel-0-oveuu4mmy.png

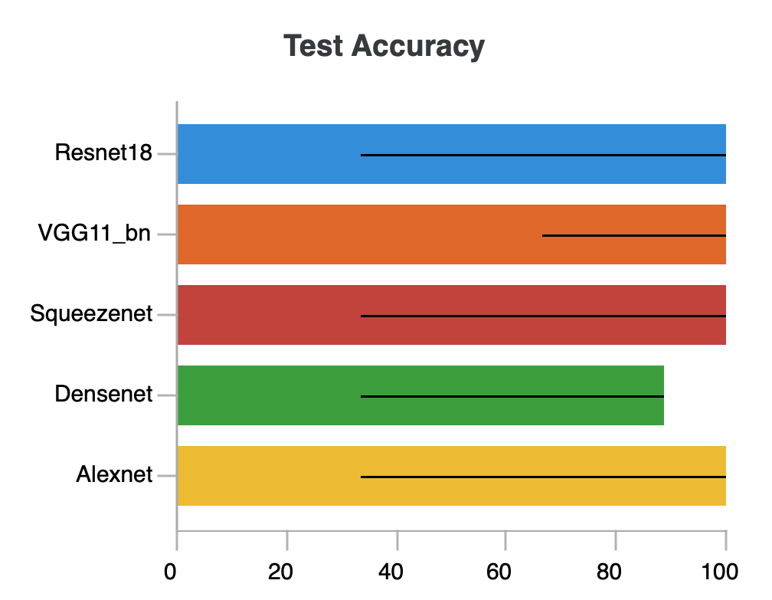
LaTeX/TussenTijdsVerslag/TexMaker/fig/results/wandb/second_handmade_sweep/charts/Section-6-Panel-0-oveuu4mmy.png
