dplars/TWI/LaTeX/TussenTijdsVerslag/TexMaker/fig/results/wandb/second_handmade_sweep/charts/valid_accuracy_best_run.png

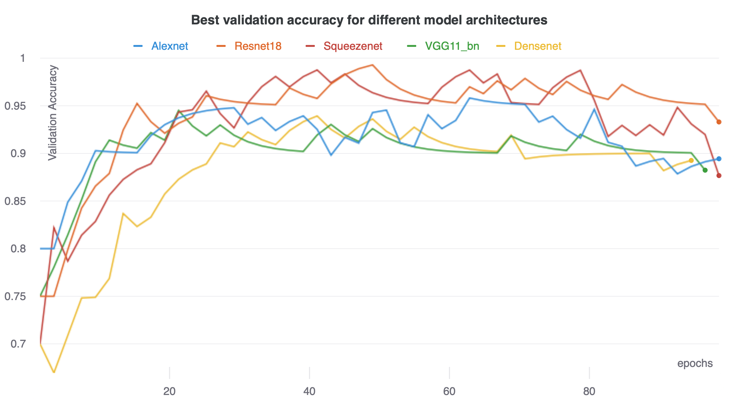
LaTeX/TussenTijdsVerslag/TexMaker/fig/results/wandb/second_handmade_sweep/charts/valid_accuracy_best_run.png
