dplars/TWI/LaTeX/TussenTijdsVerslag/TexMaker/fig/results/wandb/spaghetti_dataset/charts/Section-2-Panel-0-87nacrcca.png

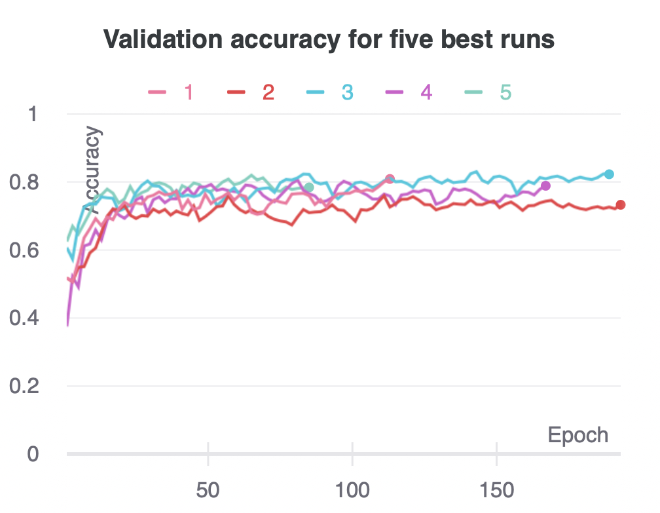
LaTeX/TussenTijdsVerslag/TexMaker/fig/results/wandb/spaghetti_dataset/charts/Section-2-Panel-0-87nacrcca.png
