dplars/TWI/LaTeX/TussenTijdsVerslag/TexMaker/fig/results/wandb/spaghetti_dataset/charts/Section-6-Panel-1-kavwspgfr.png

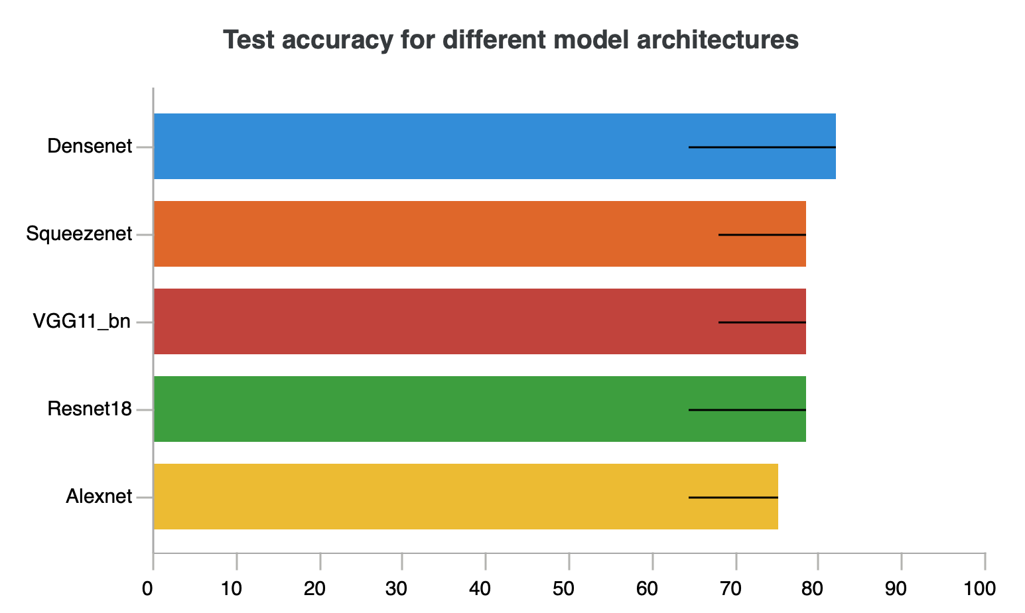
LaTeX/TussenTijdsVerslag/TexMaker/fig/results/wandb/spaghetti_dataset/charts/Section-6-Panel-1-kavwspgfr.png
