dplars/TWI/LaTeX/TussenTijdsVerslag/TexMaker/fig/results/wandb/spaghetti_dataset/charts/Section-8-Panel-1-tdcepotwj.png

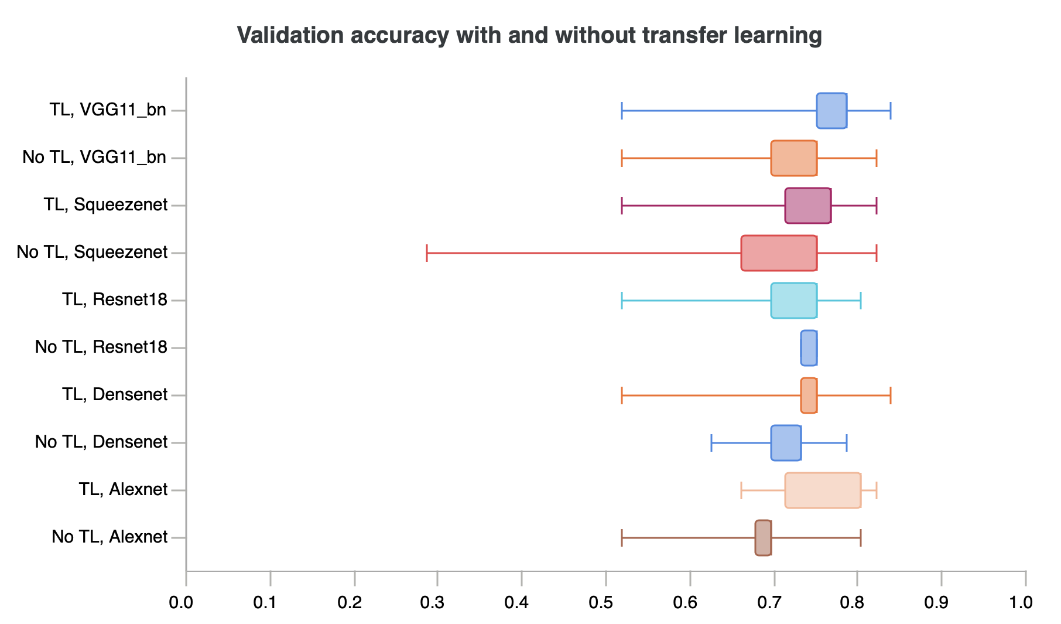
LaTeX/TussenTijdsVerslag/TexMaker/fig/results/wandb/spaghetti_dataset/charts/Section-8-Panel-1-tdcepotwj.png
