dplars/TWI/(commit log)

2020-11-13 First commit with files copied from .old folders
    [houder.stl, houder2.stl, houder3.stl, houder4.stl, houder5.stl, houder6.stl, houder7.stl, houder_afgeschuind_30grad.stl]
2020-11-13 added loop timer for time measurements
2020-11-13 Solved problem of slow loop time
    Changed the Serial timeout to 10 miliseconds
    Changed the readStringUntil on top of arduino code to ('/') instead of ('\n') which wasn't detected.
    [contol_motor_leds.ino]
2020-11-13 working software with changed image names; controls two adressable leds and a stepper motor
2020-11-13 Added extra dataset and determined the use of the stripes on the old dataset; created new wheel setup for automated image taking
    wrote some text about old and new dataset in zim
    created new dataset with labels which are included in the datasets folder
    created new wheel which is more customizable if something goes wrong again of id something breaks of the wear.
    [clip_p.stl, clip_p_2.stl, clip_p_3.stl, clip_p_4.stl, labels3.csv, labels4.csv, labels_new_bullet.xlsx, rad2.stl]
2020-11-14 added pictures to the zim dataset page
    [labels_new_bullet.xlsx]
2020-11-18 created first classification model
    Tested and trained on second hand made dataset of 100 images. Pretty good results but dataset was not equally spread started the making of a nice result output file
    [labels4.csv, labels_new_bullet.xlsx]
2020-11-24 Added new models for radhouder
    [radhouder_v2_num.stl, radhouder_v2_num_V2.stl]
2020-12-02 spaghetti dataset added and tested with wandb.
    Added extra documentation for some datasets
    Created new algorithm for all networks
    added new dataset spaghetti of all inserts
    [2020_camera houder v1.stl, 2020_camera houder_4.stl, 2020_camera houder_draai_houder.stl, 2020_camera_houder_2.stl, 2020_camerahouder.stl, 2020_klem.stl, 2020_uniform_X_shape_with_half_support.stl, 20x20(Double).stp]
2020-12-04 Added documentation to datasets, all networks and wheel holder
    Created documentation for spaghetti dataset. with images and errors possible in the dataset
    Added an information file per All networks notebook to discuss results. These are found on Wandb as reports in the projects folders
    Added pictures of the new wheel holder and short documentation of the new design an print errors
    [clip_9.stl]
2020-12-08 Added latex for writing files and inserted zim files into latex
    [radhouder.stl]
2020-12-12 Wrote text and created result charts
    Copied zim text into latex as well as reports from wandb
    finished Results chapter
    Created text for all chapters, still needs second opinion
    [Section-16-Table.csv, Section-18-Table.csv, USB Microscope_Generic.STEP, USB Microscope_Generic.igs, USB_Microscope_R0.SLDPRT, labels5.xlsx]
2020-12-16 Text second version finished
    Added renders for setup and text was read a second time with help from D.H.
    [Holder nema17 grav.STL, Holder nema17.SLDPRT, LED segment, 144 pitch.SLDPRT, PROFILE_20х20.SLDPRT, PROFILE_20х20.STEP, labels5.xlsx]
